zfeuers1/Junior-Design/Project Documents/PowerManagementV1.jpg

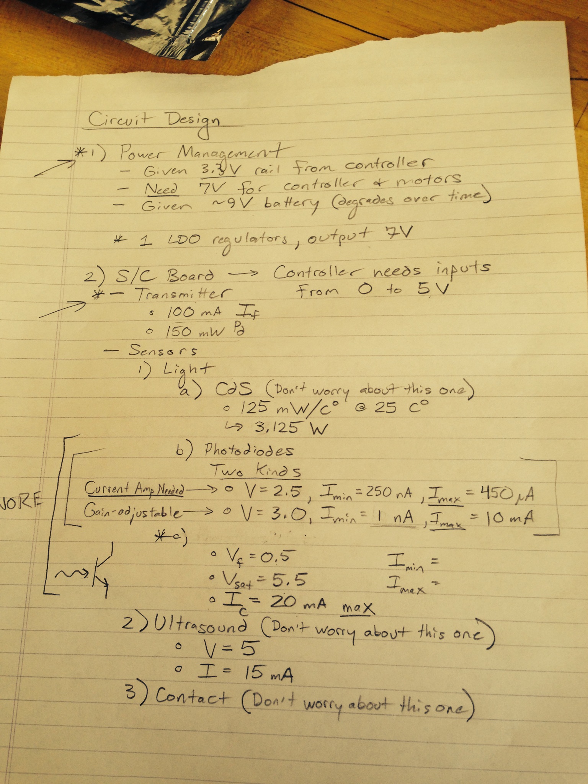
Project Documents/PowerManagementV1.jpg
