zfeuers1/Junior-Design/README.md

Junior-Design-Project
=============

Project for my Junior Design class at Binghamton University (Spring 2014).

Look at "Project Description.pdf" for more details.

Code is all in RobotControl
