zfeuers1/Junior-Design/Project Documents/JDT 18 Design Review/Flowcharts.pdf

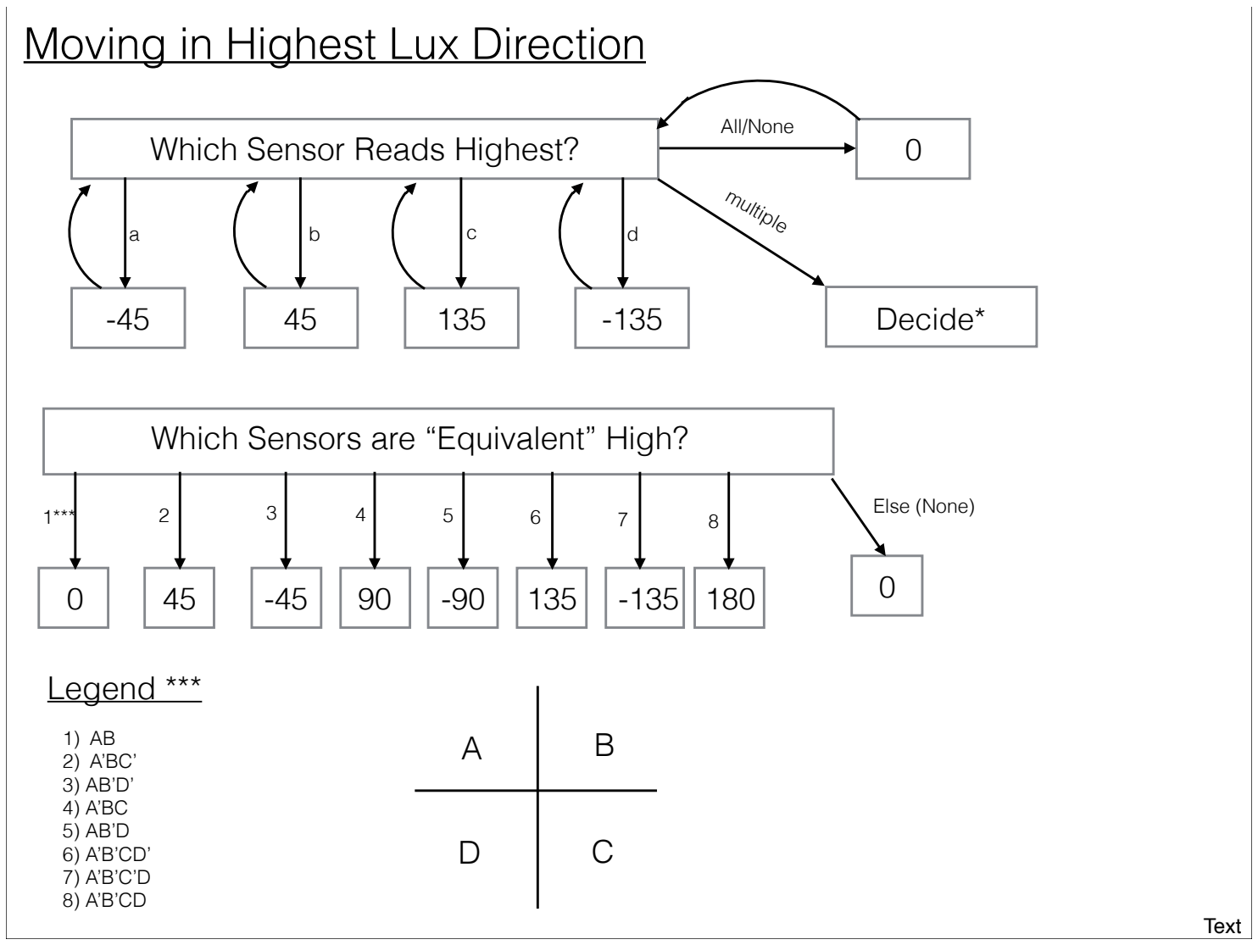
[picture p3: figure]
Moving in Highest Lux Direction; Which Sensor Reads Highest?; Decide*; multiple; All/None; Else (None) 1***; Which Sensors are “Equivalent” High?; Legend ***

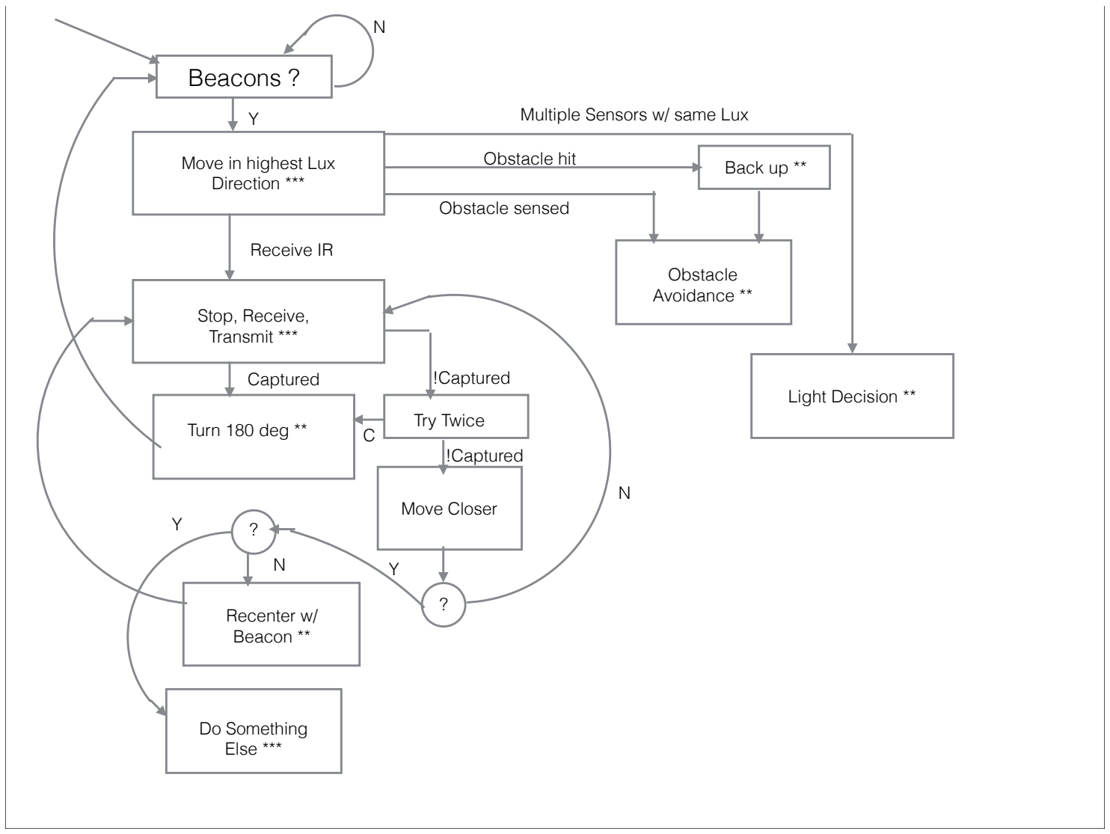
[picture p4: figure]
Beacons ?; Move in highest Lux Direction ***; Multiple Sensors w/ same Lux; Obstacle hit; Obstacle sensed; Back up **; Obstacle Avoidance **; Light Decision **; Stop, Receive, Transmit ***; Receive IR; Captured; !Captured; Try Twice; Turn 180 deg **; Move Closer; Recenter w/ Beacon **; Do Something Else ***

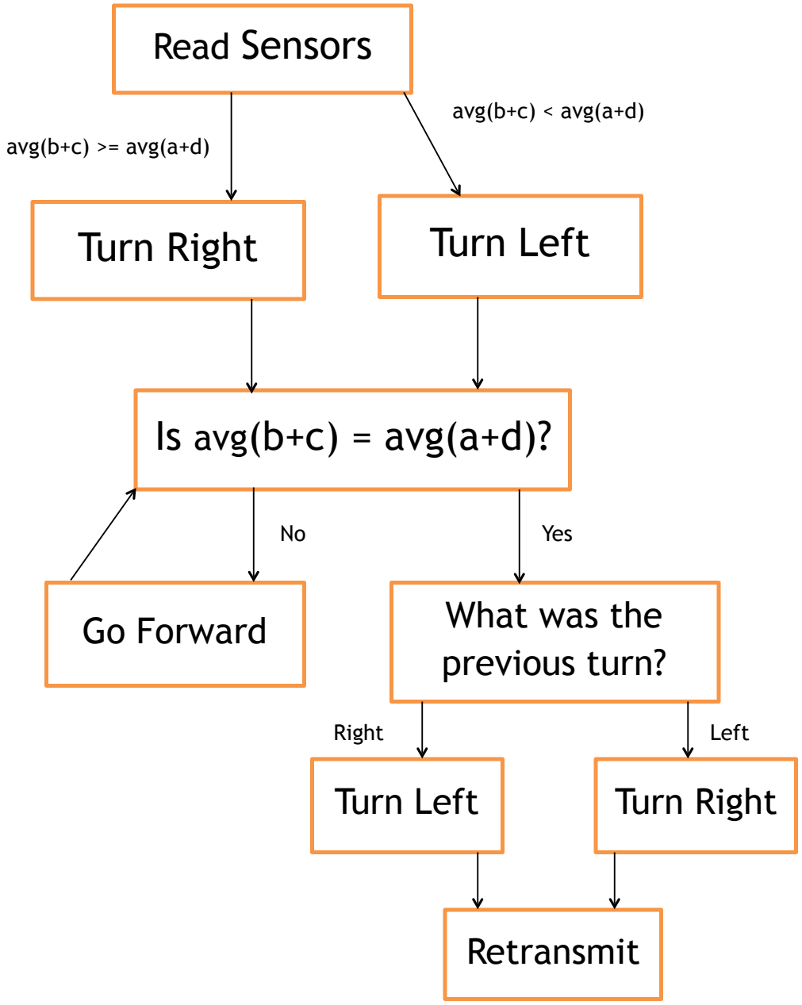
[picture p5: figure]
Read Sensors; Turn Right; Turn Left; Is avg(b+c) = avg(a+d)?; Go Forward; What was the; previous turn?; Retransmit; avg(b+c) >= avg(a+d); avg(b+c) < avg(a+d); Yes; Right; Left
