zfeuers1/Junior-Design/Project Documents/JDT 18 Design Review/BlockDiagram.pdf

# Block Diagram

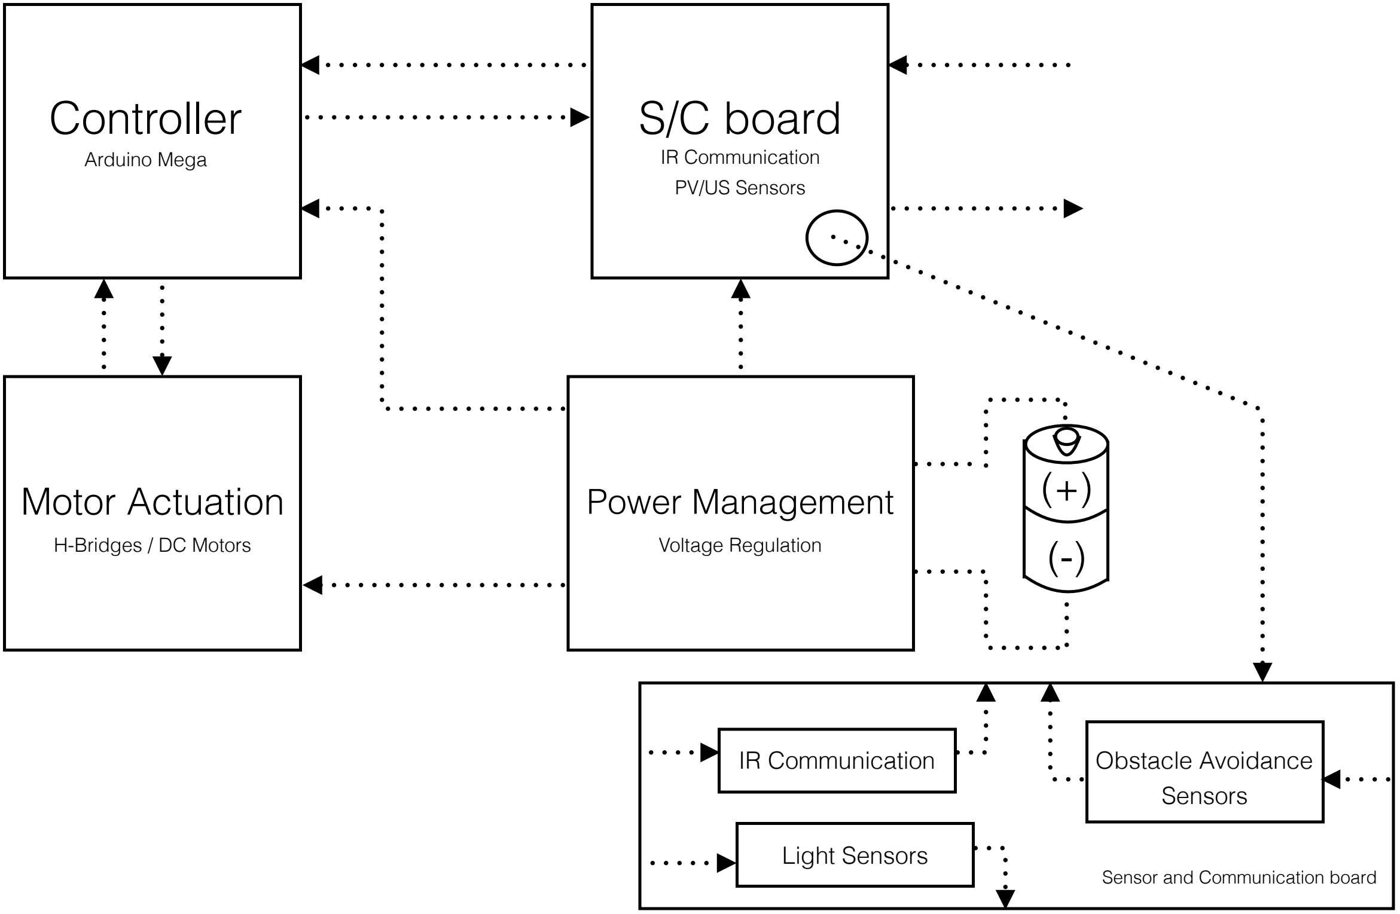
[picture p6: figure]
Controller; S/C board; Motor Actuation; Power Management; Arduino Mega; IR Communication; PV/US Sensors; H-Bridges / DC Motors; Light Sensors; Sensor and Communication board; Obstacle Avoidance Sensors; Voltage Regulation

# Controller

# Arduino Mega Atmel

## Atmega 2560

Analog I/O Pins | Communication Pins

# Digital I/O Pins

# Digital I/O Pins

## Power

## USB

# Motor Actuation

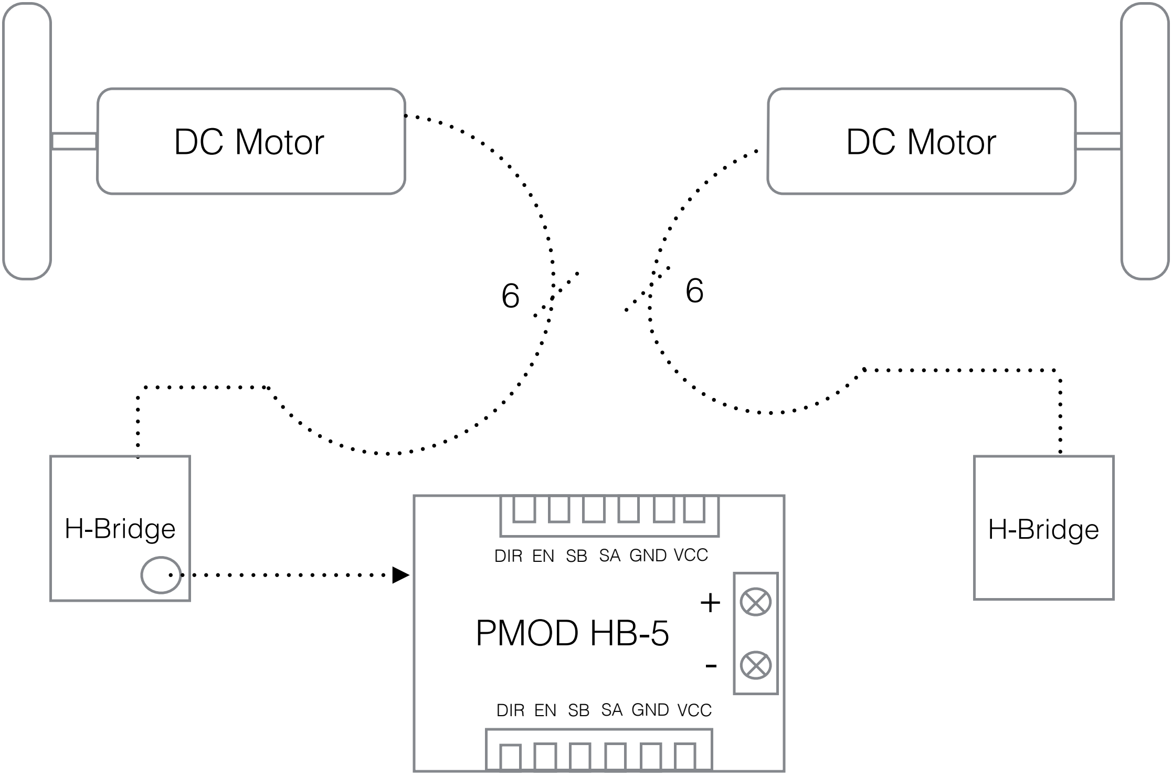
[picture p7: figure]
H-Bridge; DC Motor; DIR EN SB SA GND VCC; PMOD HB-5

# Sensors and Communications

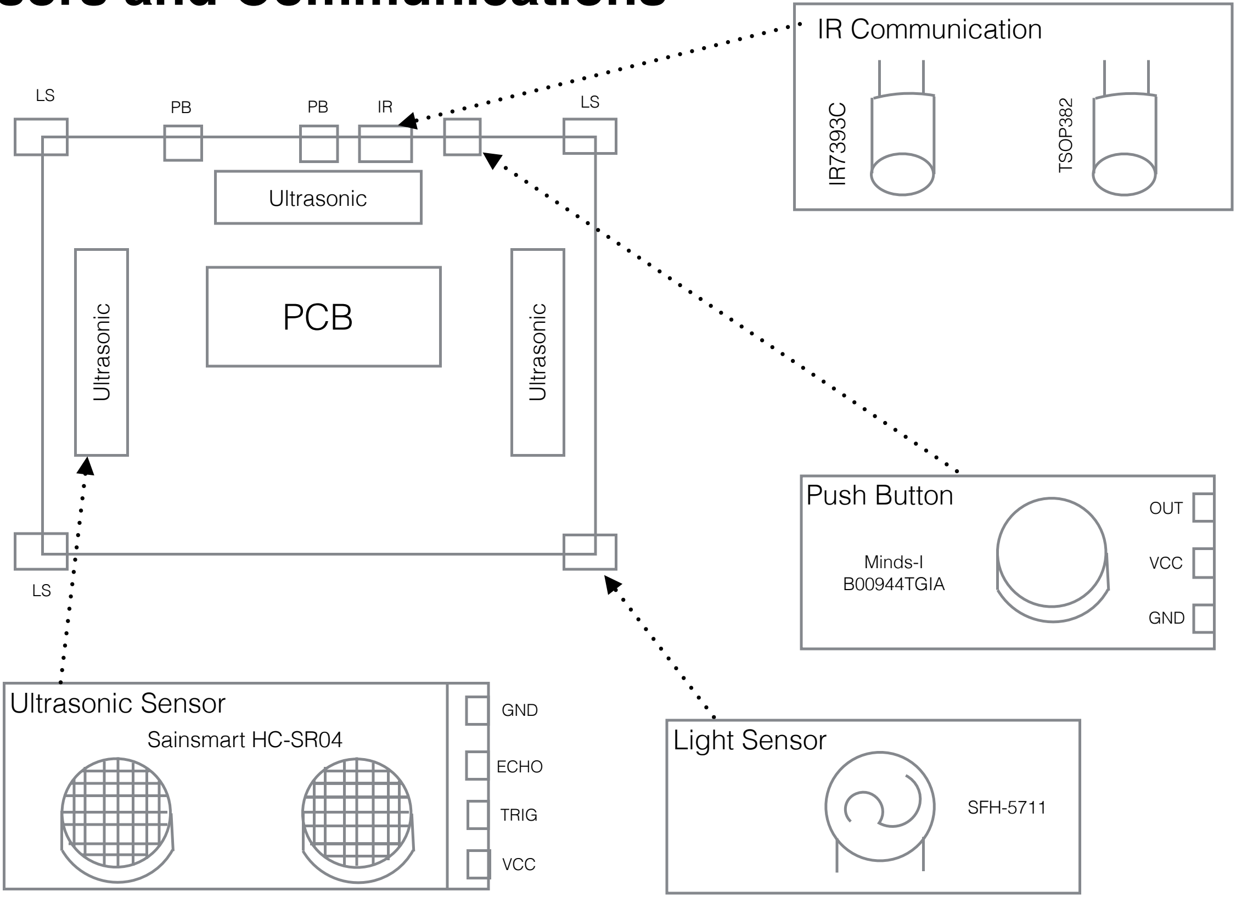
[picture p8: figure]
Ultrasonic; IR Communication; Light Sensor; Push Button; Ultrasonic Sensor; OUT; VCC; GND; Minds-I B00944TGIA; PCB; TSOP382; SFH-5711; Sainsmart HC-SR04; ECHO; TRIG

# Power Management

9v

# GND

# GND 5v

3.3uF

# Batteries

# MIC5239

+

# 5v Rail
