zfeuers1/Junior-Design/Project Documents/JDT 18 Design Review/PSPICE Simulations.pdf

SFH 5711 - Photodiode

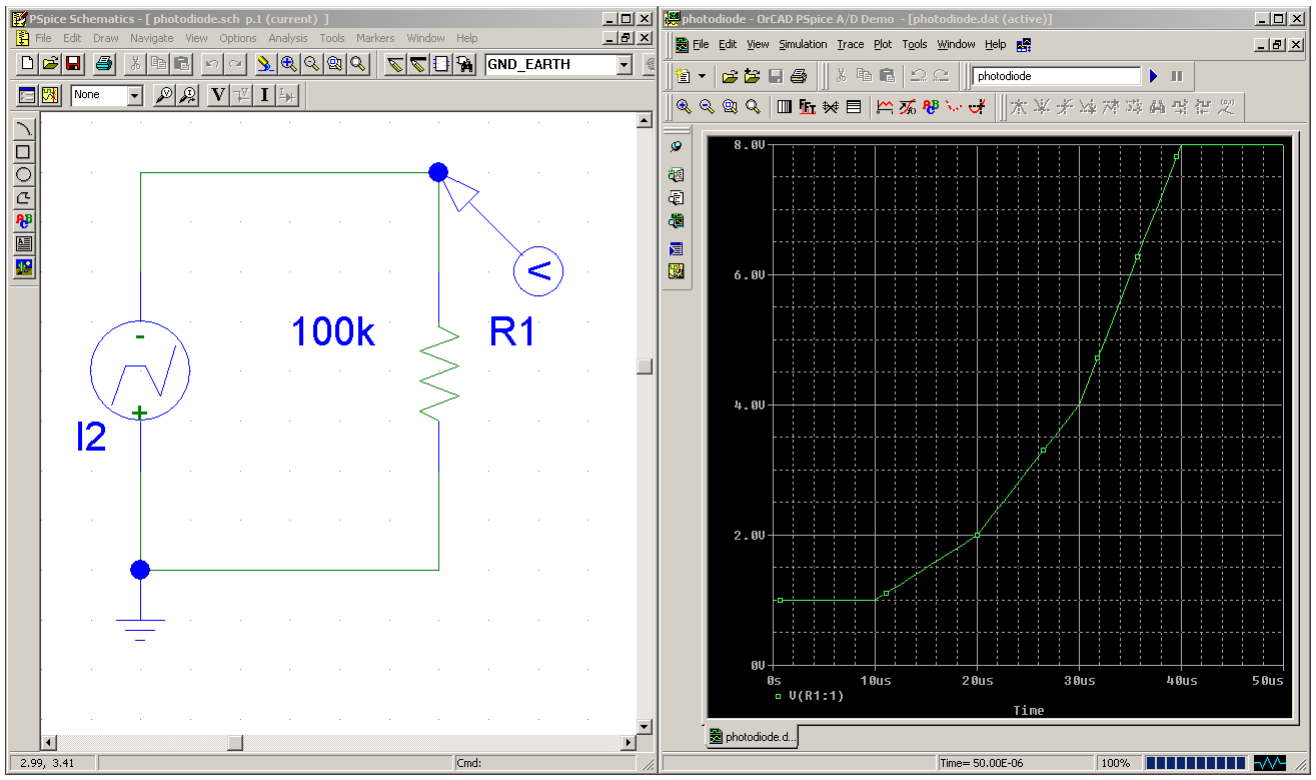
[picture p9: figure]

IR Transmitter Circuit (Clock Signals acting as IR_CC and 38_kHz)

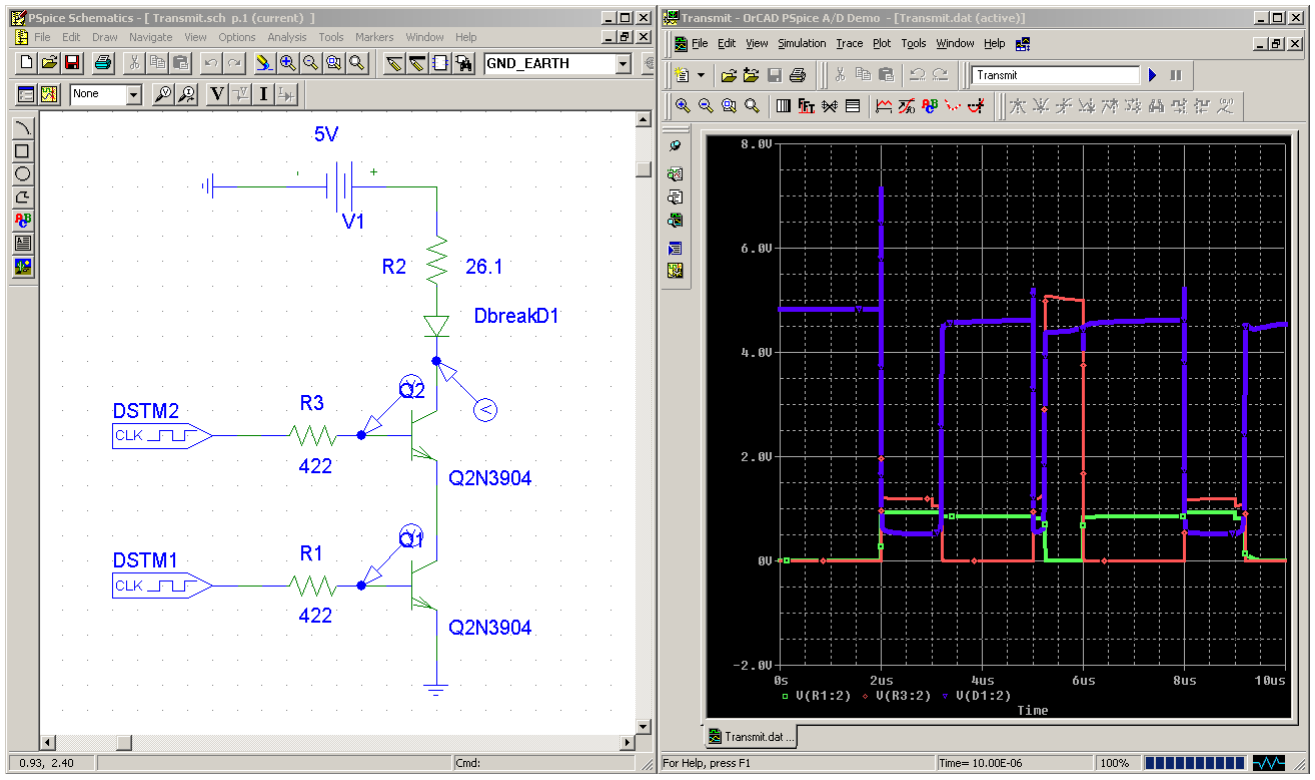
[picture p10: figure]
