zfeuers1/Junior-Design/Project Documents/LSnew.pdf

# Moving in Highest Lux Direction

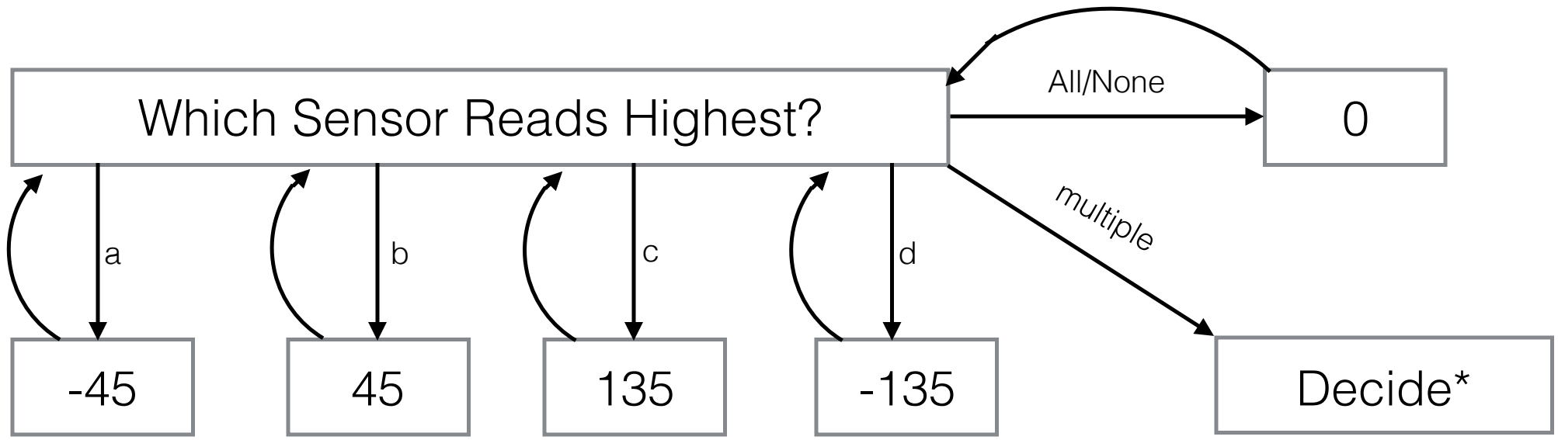
[picture p11: figure]
Which Sensor Reads Highest?; Decide*; multiple; All/None

Else (None) 1*** | 2 | 3 | 4 | 5 | 6 | 7 | 8
0 | 45 | -45 | 90 | -90 | 135 | -135 180 | 0

## Which Sensors are “Equivalent” High?

## Legend ***

1) AB
2) A’BC’
3) AB’D’
4) A’BC
5) AB’D
6) A’B’CD’
7) A’B’C’D
8) A’B’CD
A | B
D | C

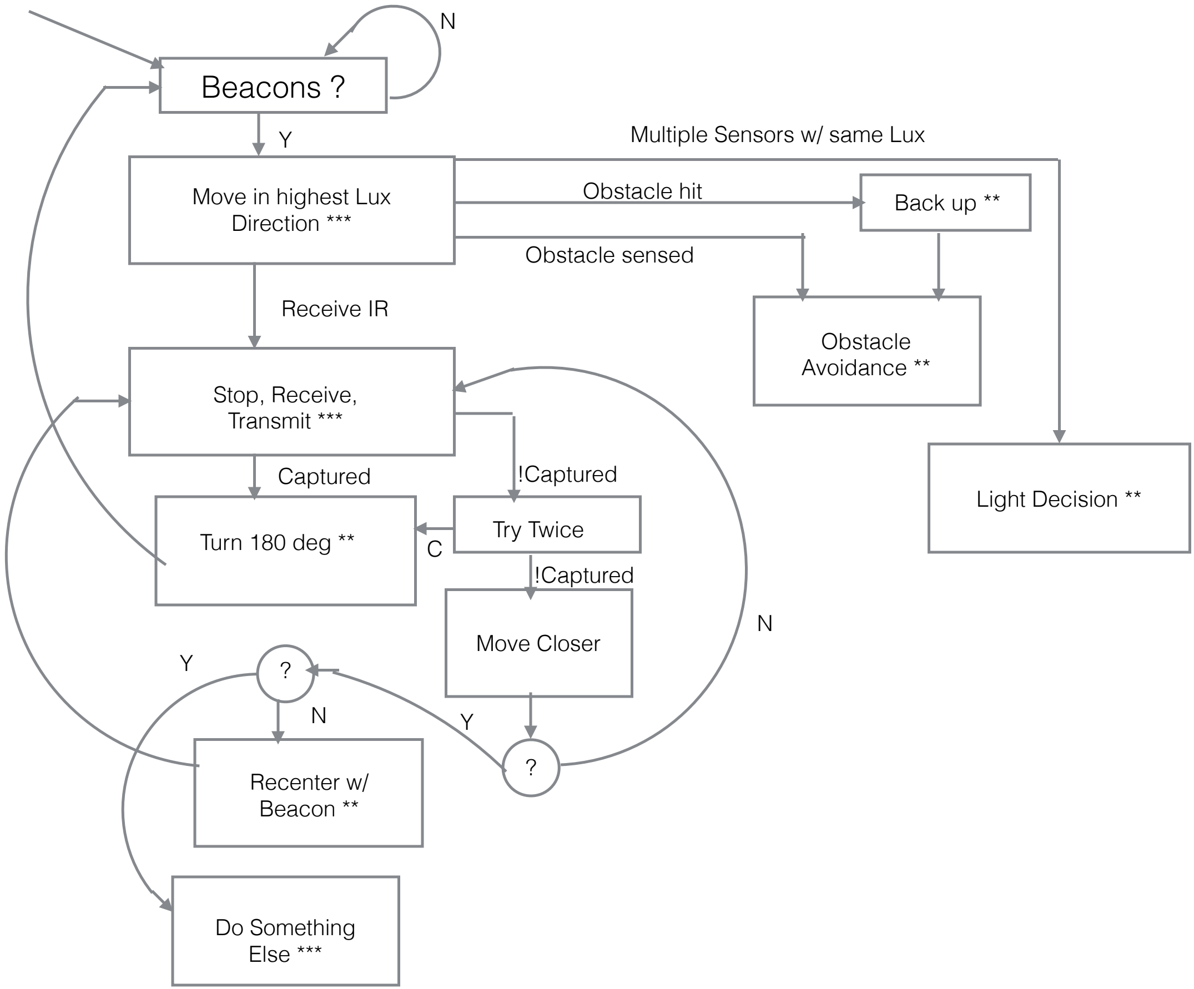
[picture p12: figure]
Beacons ?; Move in highest Lux Direction ***; Multiple Sensors w/ same Lux; Obstacle hit; Obstacle sensed; Back up **; Obstacle Avoidance **; Light Decision **; Stop, Receive, Transmit ***; Receive IR; Captured; !Captured; Try Twice; Turn 180 deg **; Move Closer; Recenter w/ Beacon **; Do Something Else ***
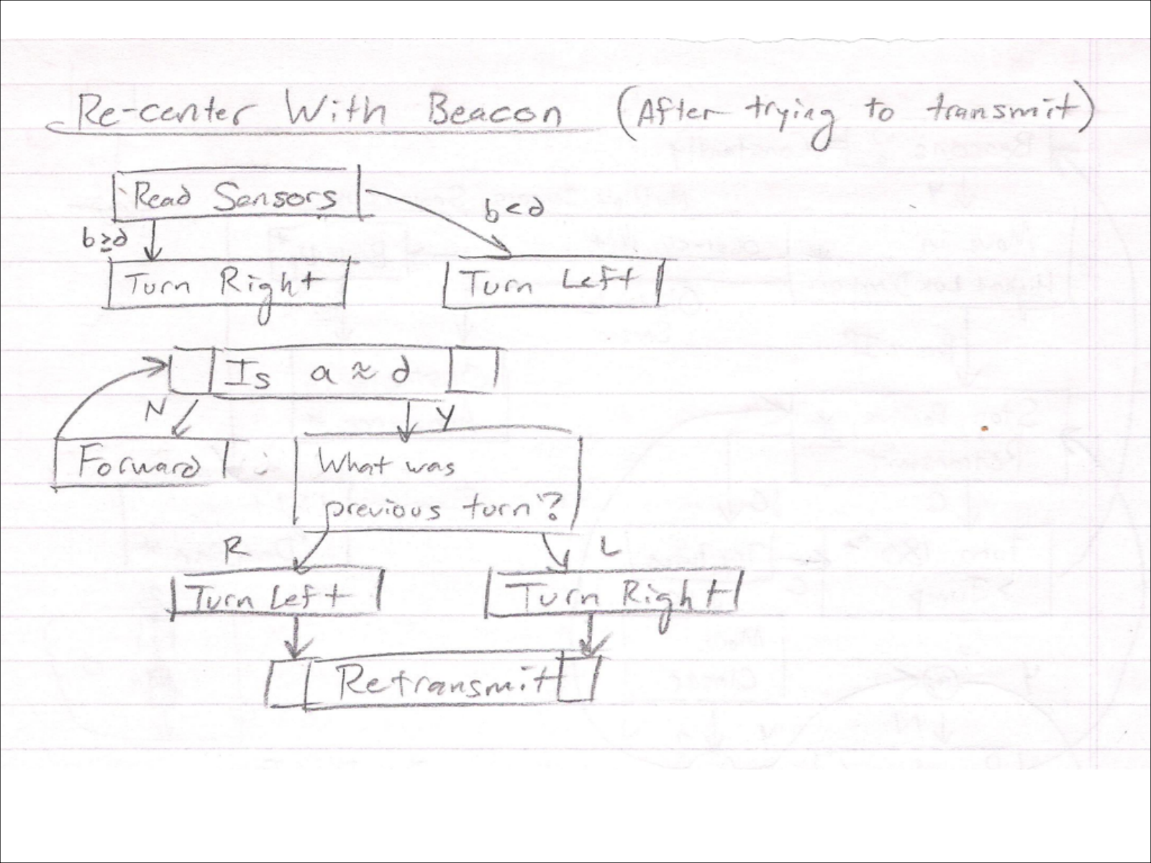
[picture p13: page 3]
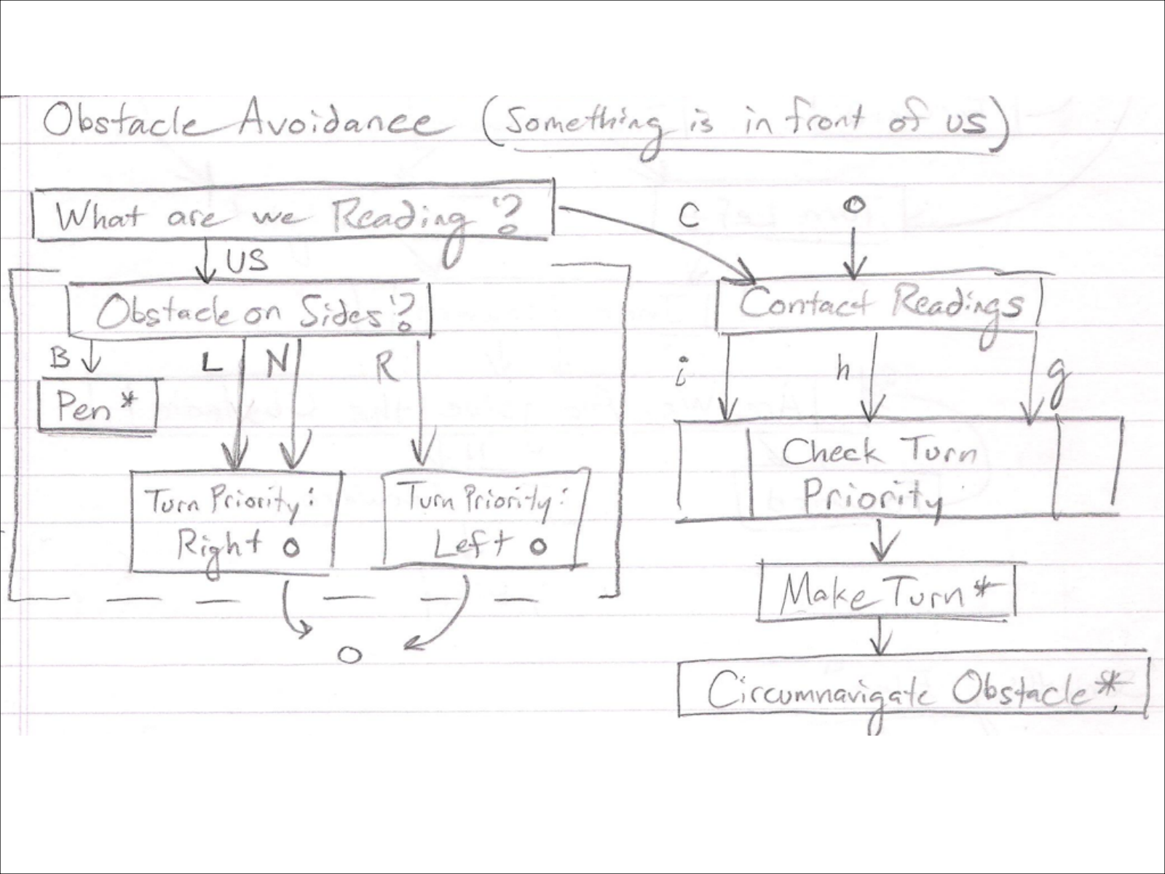
[picture p14: page 4]
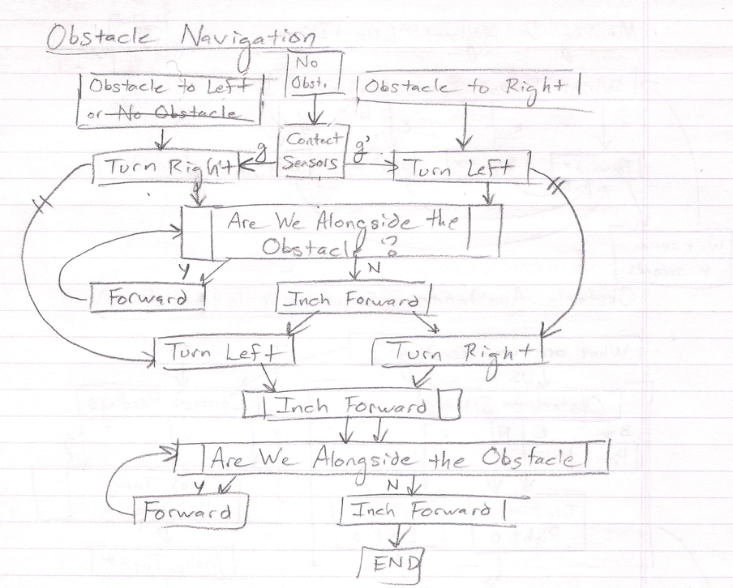
[picture p15: page 5]
