zfeuers1/Junior-Design/Project Documents/BlockDiagram.pdf

# Block Diagram

Controller; S/C board; Motor Actuation; Power Management; Arduino Mega; IR Communication; PV/US Sensors; H-Bridges / DC Motors; Light Sensors; Sensor and Communication board; Obstacle Avoidance Sensors; Voltage Regulation

# Controller

# Arduino Mega Atmel

## Atmega 2560

Analog I/O Pins | Communication Pins

# Digital I/O Pins

# Digital I/O Pins

## Power

## USB

# Motor Actuation

H-Bridge; DC Motor; DIR EN SB SA GND VCC; PMOD HB-5

# Sensors and Communications

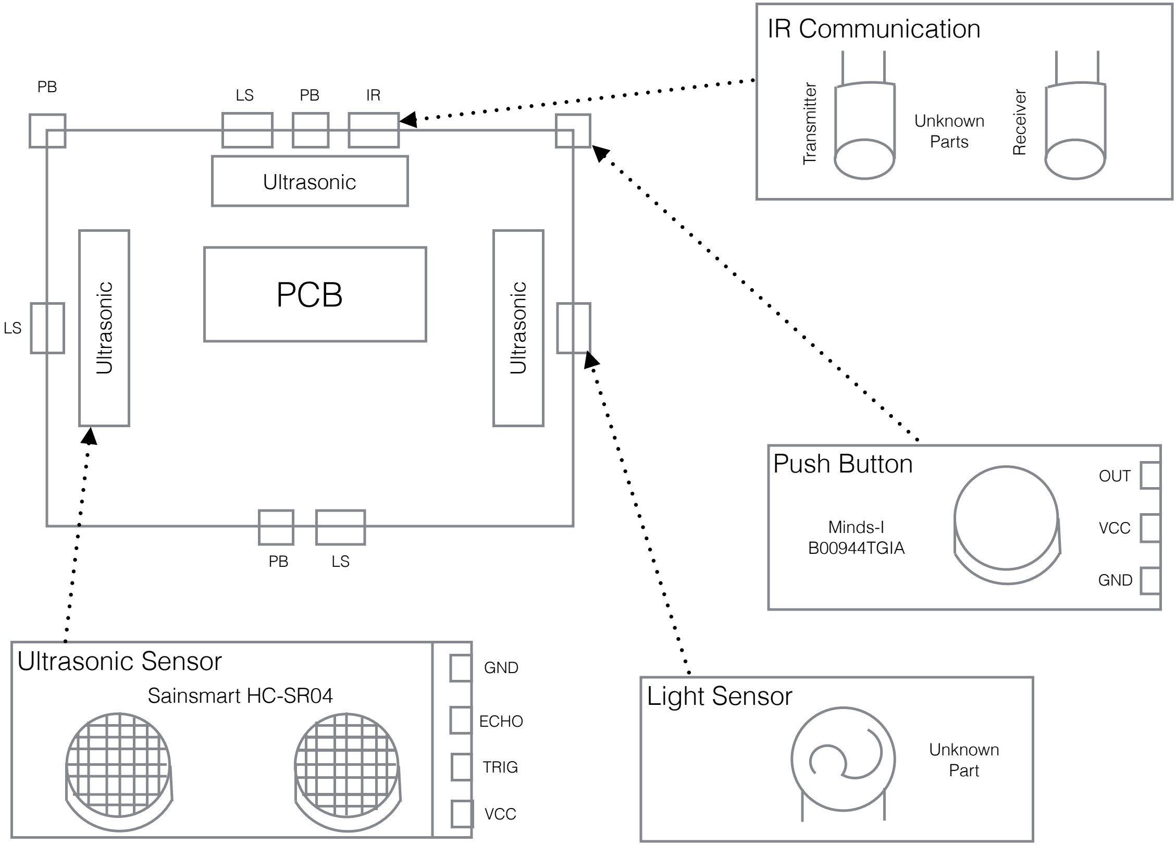
[picture p16: figure]
Ultrasonic; IR Communication; Light Sensor; Push Button; Ultrasonic Sensor; OUT; VCC; GND; Minds-I B00944TGIA; PCB; Transmitter; Receiver; Unknown Part; Unknown Parts; Sainsmart HC-SR04; ECHO; TRIG

# Power Management
