zfeuers1/Junior-Design/Project Documents/Schematic.pdf

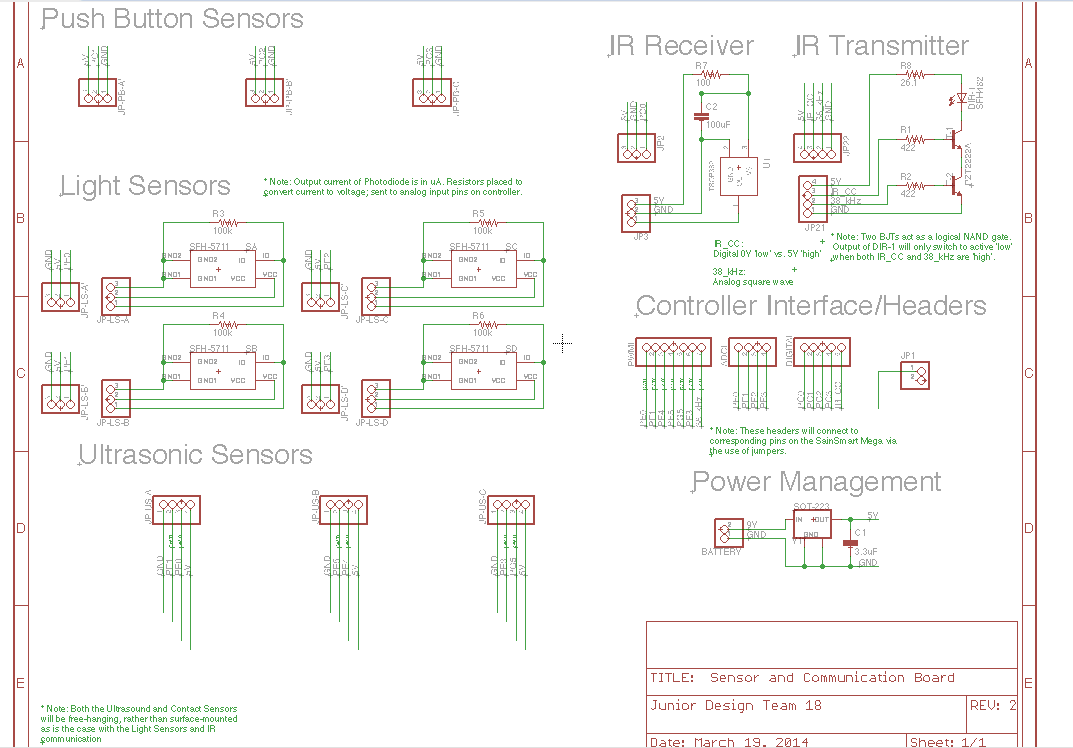
[picture p17: figure]
