zfeuers1/Junior-Design/Project Documents/JDT 18 Design Review/IR Transmitter Justifications.pdf

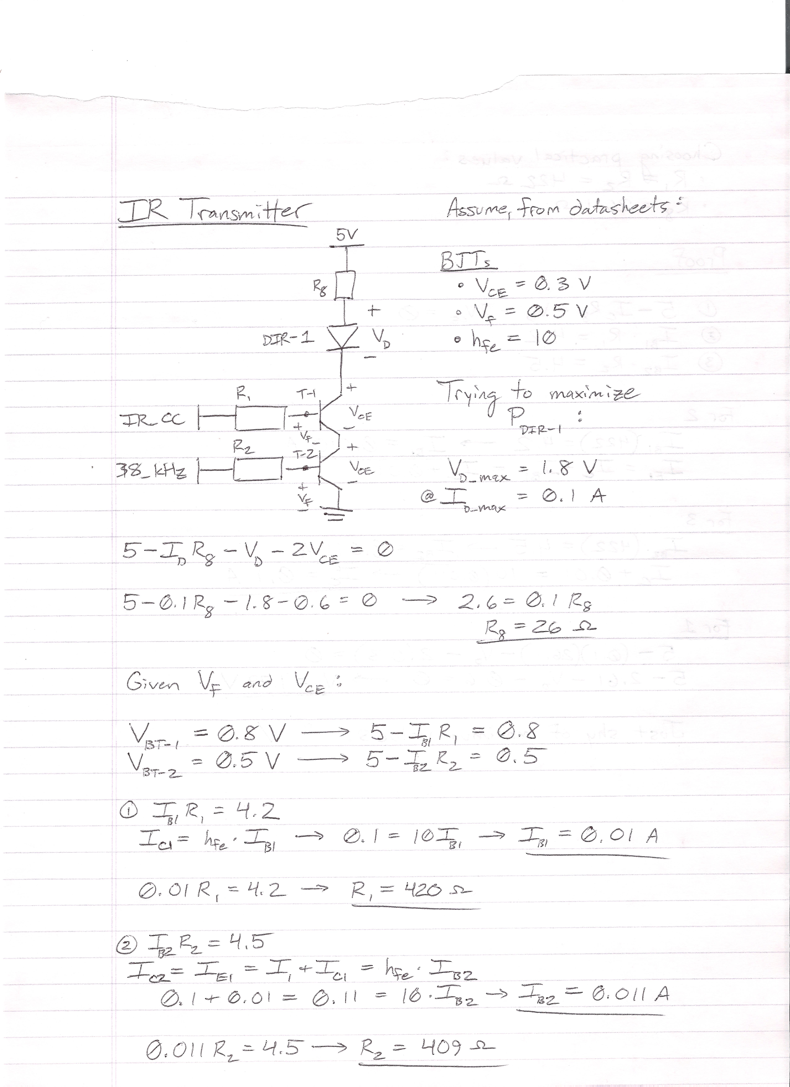
[picture p18: page 1]
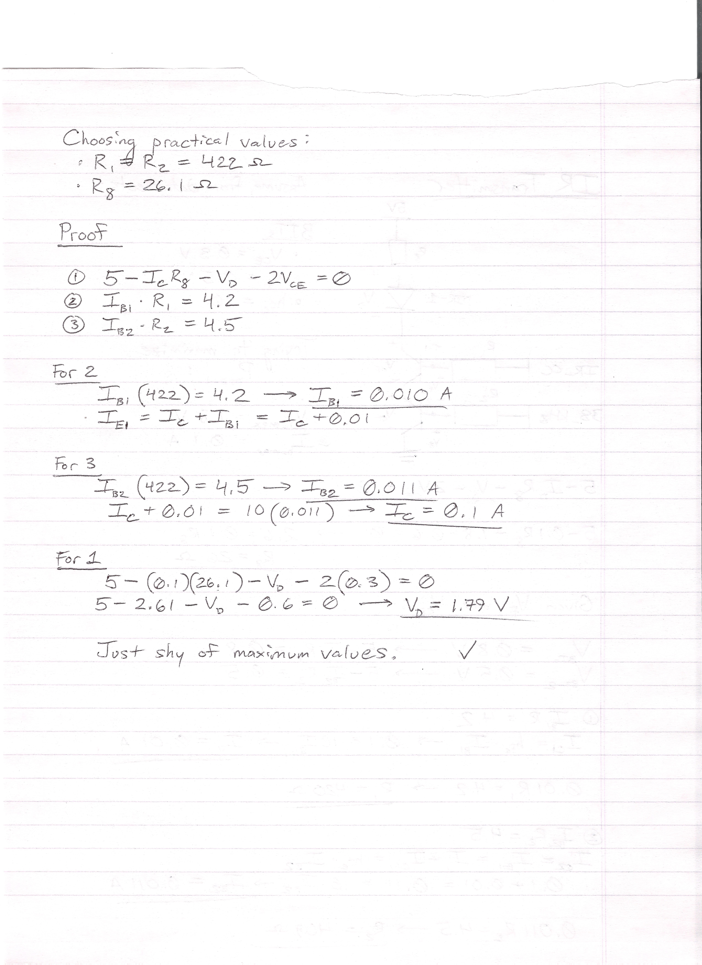
[picture p19: page 2]
