zfeuers1/Junior-Design/Project Documents/JDT 18 Design Review/Schematic:PCB/PCB/IR Transmitter and Reciever.pdf

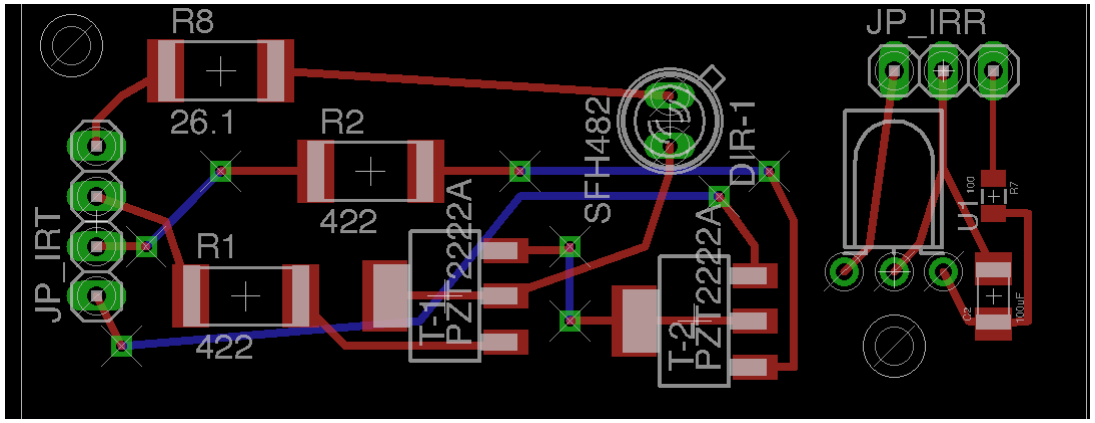
[picture p20: figure]
