zfeuers1/Junior-Design/Project Documents/JDT 18 Design Review/Schematic:PCB/PCB/Light Sensor.pdf

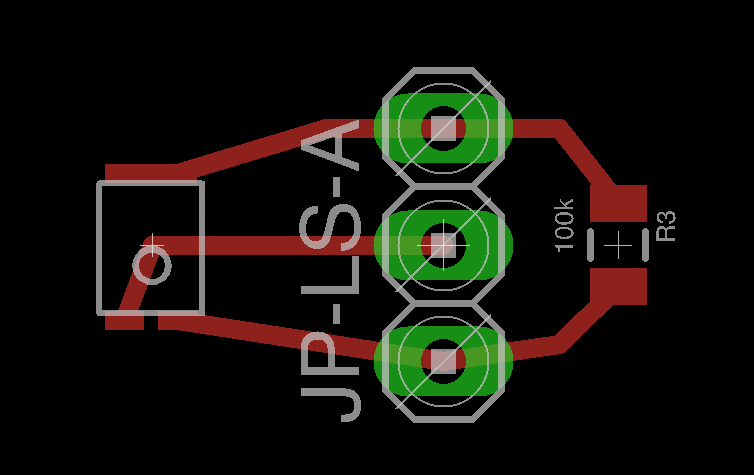
[picture p21: figure]
