zfeuers1/Junior-Design/Project Documents/JDT 18 Design Review/Schematic:PCB/PCB/PCB.pdf

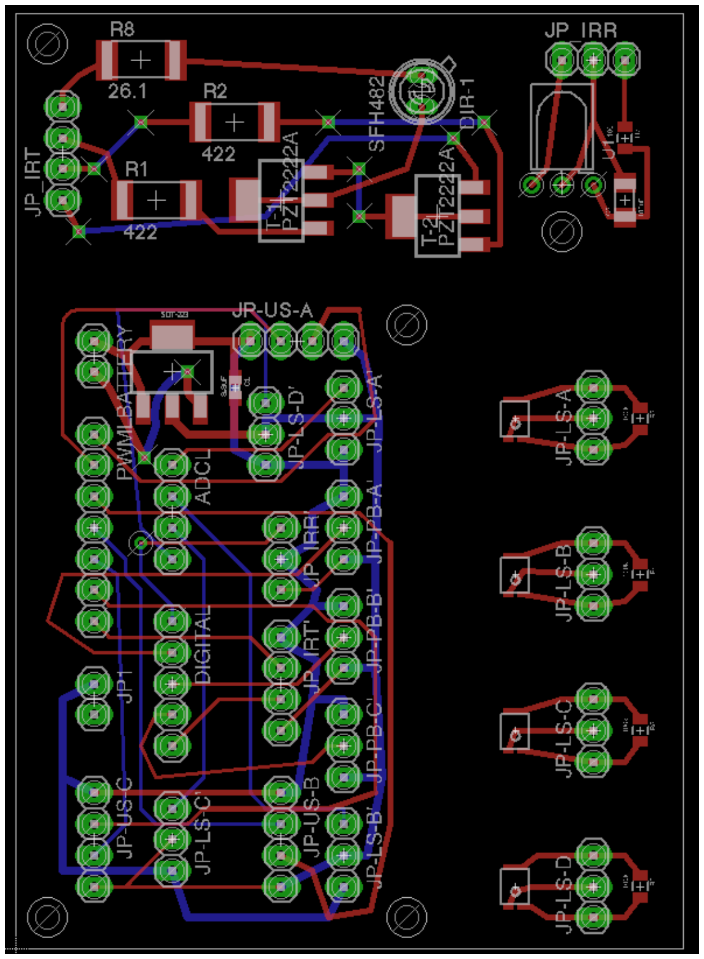
[picture p22: page 1]
