zfeuers1/Junior-Design/Project Documents/IR Reciever and Transmitter.pdf

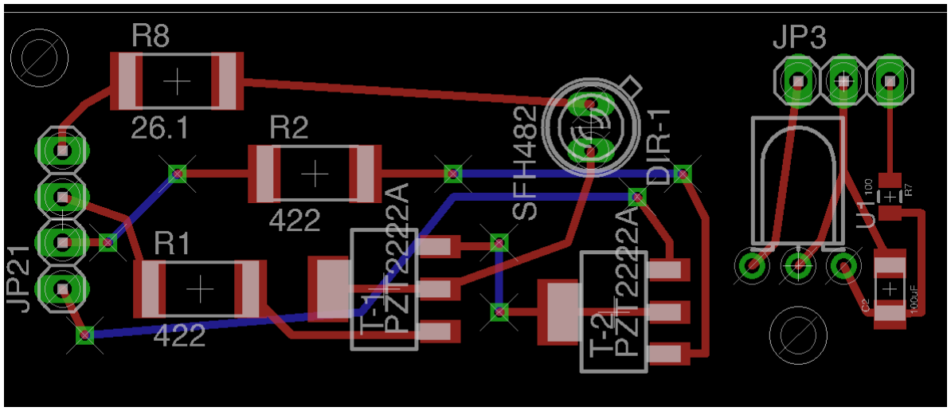
[picture p23: figure]
