zfeuers1/Junior-Design/Project Documents/PCB.pdf

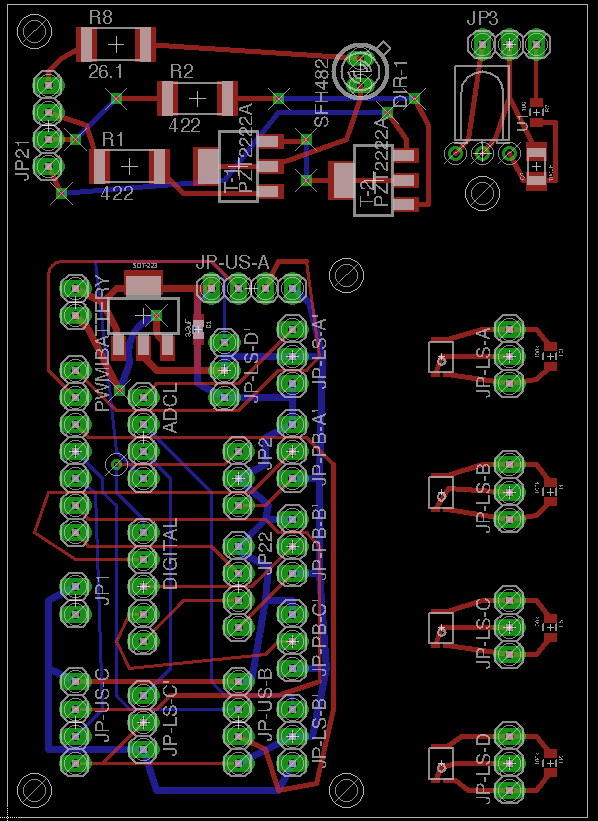
[picture p24: page 1]
