zfeuers1/Junior-Design/Project Documents/BlockDiagram.key/Data/st0-710.jpg

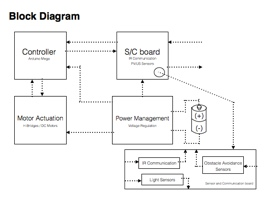
Project Documents/BlockDiagram.key/Data/st0-710.jpg
