zfeuers1/Junior-Design/Project Documents/BlockDiagram.key/Data/st1-819.jpg

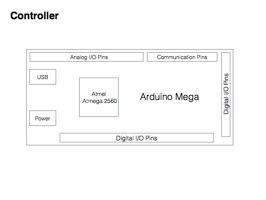
Project Documents/BlockDiagram.key/Data/st1-819.jpg
