zfeuers1/Junior-Design/Project Documents/BlockDiagram.key/Data/st2-1750.jpg

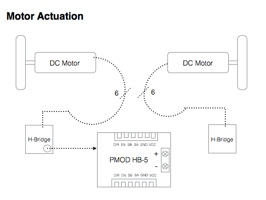
Project Documents/BlockDiagram.key/Data/st2-1750.jpg
