zfeuers1/Junior-Design/Project Documents/BlockDiagram.key/Data/st3-1954.jpg

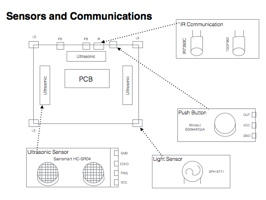
Project Documents/BlockDiagram.key/Data/st3-1954.jpg
