zfeuers1/Junior-Design/Project Documents/BlockDiagram.key/Data/st4-1948.jpg

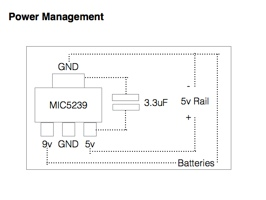
Project Documents/BlockDiagram.key/Data/st4-1948.jpg
