zfeuers1/Junior-Design/Project Documents/Flowcharts.key/Data/pasted-image-small-515.png

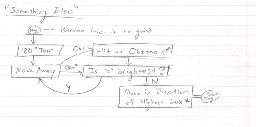
Project Documents/Flowcharts.key/Data/pasted-image-small-515.png
