zfeuers1/Junior-Design/Project Documents/Flowcharts.key/Data/pasted-image-small-532.png

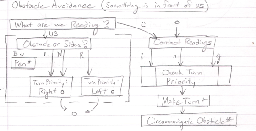
Project Documents/Flowcharts.key/Data/pasted-image-small-532.png
