zfeuers1/Junior-Design/Project Documents/Flowcharts.key/Data/pasted-image-small-543.png

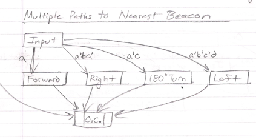
Project Documents/Flowcharts.key/Data/pasted-image-small-543.png
