zfeuers1/Junior-Design/Project Documents/Flowcharts.key/Data/pasted-image-small-549.png

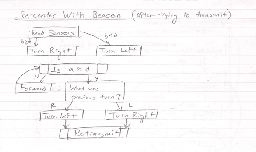
Project Documents/Flowcharts.key/Data/pasted-image-small-549.png
