zfeuers1/Junior-Design/Project Documents/Flowcharts.key/Data/st1-571.jpg

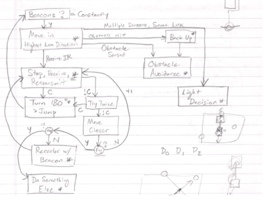
Project Documents/Flowcharts.key/Data/st1-571.jpg
