zfeuers1/Junior-Design/Project Documents/Flowcharts.key/Data/st2-520.jpg

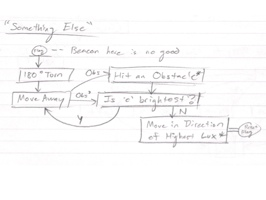
Project Documents/Flowcharts.key/Data/st2-520.jpg
