zfeuers1/Junior-Design/Project Documents/Flowcharts.key/Data/st3-529.jpg

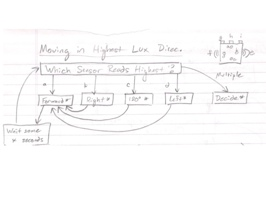
Project Documents/Flowcharts.key/Data/st3-529.jpg
