zfeuers1/Junior-Design/Project Documents/Flowcharts.key/Data/st5-546.jpg

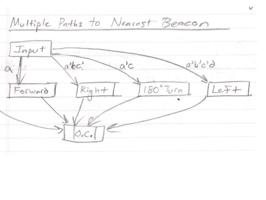
Project Documents/Flowcharts.key/Data/st5-546.jpg
