zfeuers1/Junior-Design/Project Documents/Flowcharts.key/Data/st5-576.jpg

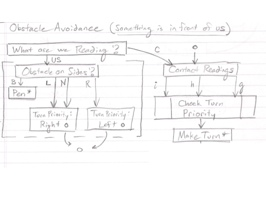
Project Documents/Flowcharts.key/Data/st5-576.jpg
