zfeuers1/Junior-Design/Project Documents/Flowcharts.key/Data/st6-560.jpg

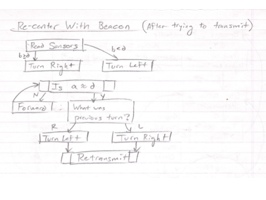
Project Documents/Flowcharts.key/Data/st6-560.jpg
