zfeuers1/Junior-Design/Schematics/Final Schematics/Screen Shot 2014-04-04 at 2.54.39 PM.png

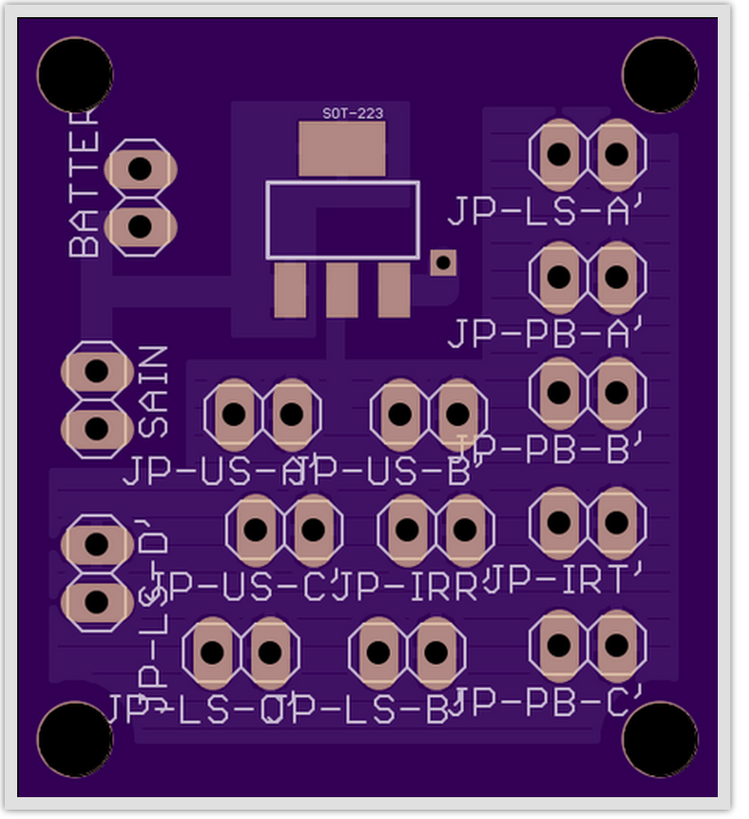
Schematics/Final Schematics/Screen Shot 2014-04-04 at 2.54.39 PM.png
