zfeuers1/Junior-Design/Schematics/Final Schematics/Screen Shot 2014-04-04 at 3.04.48 PM.png

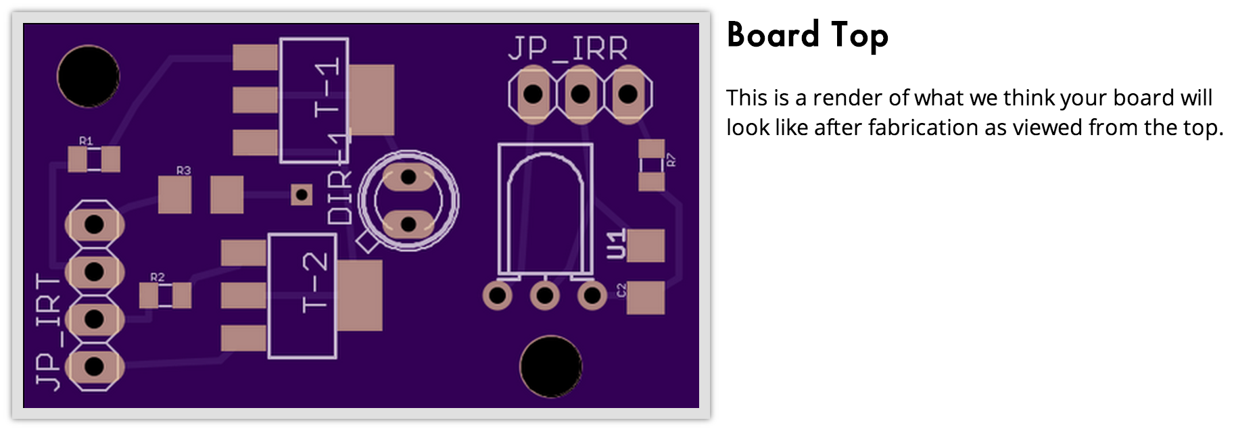
Schematics/Final Schematics/Screen Shot 2014-04-04 at 3.04.48 PM.png
