zfeuers1/Junior-Design/Independent Assignement/Independent Assignment.asc

C2: cap; .1µ
C3: cap; 1nF
D1: LED; NSPW500BS
Q1: npn; 2N2222
R1: res; 10
R2: res; 4.7k
R3: res; 100k
R4: res; 17k
U1: NE555
V1: voltage; 5
Named nets: 0
.tran 0 .125ms
