zfeuers1/Junior-Design/Independent Assignement/Independent_Assignment.brd

## EAGLE design Independent Assignement/Independent_Assignment.brd (2014-04-17)

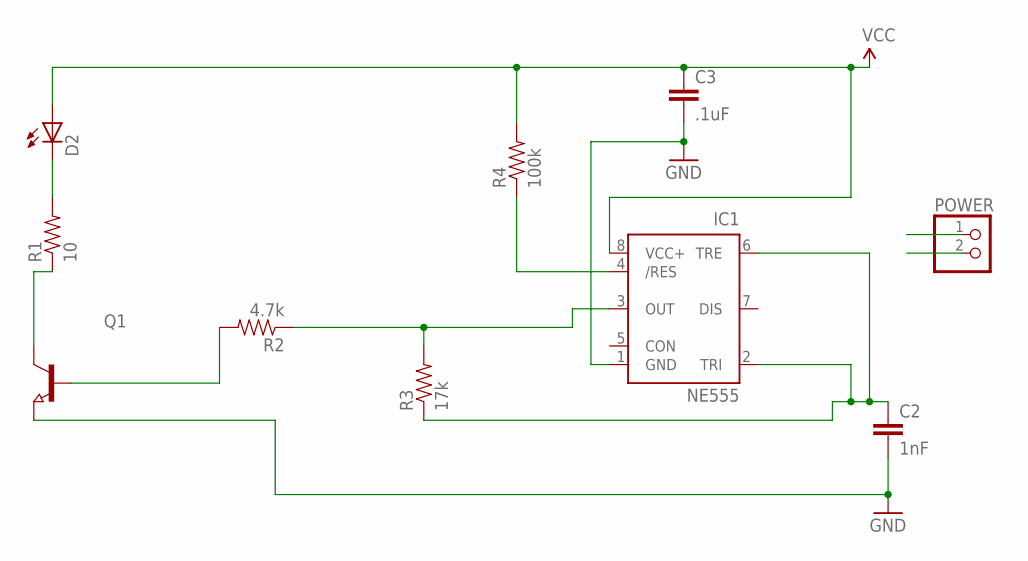
[picture p44: schematic Independent_Assignment.sch]

Parts:
C2: 1nF; 0603-CAP
C3: .1uF; 0603-CAP
D2: SFH482
IC1: NE555; DIL-08
POWER: PINHD-1X2; 1X02
Q1: NPN-TRANSISTOR_SOT23W; SOT23W
R1: 10; 0603-RES
R2: 4.7k; 0603-RES
R3: 17k; 0603-RES
R4: 100k; 0603-RES

Connections:
GND: C2.2, C3.2, IC1.1 (GND), POWER.2, Q1.3 (E)
unnamed: C2.1, IC1.2 (TRI), IC1.6 (TRE), R3.1
unnamed: D2.K (C), R1.2
unnamed: Q1.2 (C), R1.1
unnamed: Q1.1 (B), R2.2
unnamed: IC1.3 (OUT), R2.1, R3.2
unnamed: IC1.4 (/RES), R4.1
VCC: C3.1, D2.A, IC1.8 (VCC+), POWER.1, R4.2

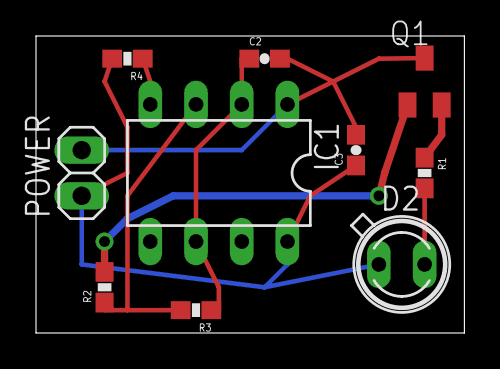
[picture p45: board Independent_Assignment.brd from above]

Board: 2 copper layers, 23.8 x 16.5 mm, 10 parts (0 on the bottom side), 8 nets.
