zfeuers1/Junior-Design/Schematics/Old Schematics/Schematics V2/Final Schematic.brd

## EAGLE design Schematics/Old Schematics/Schematics V2/Final Schematic.brd (2014-04-17, an earlier design)

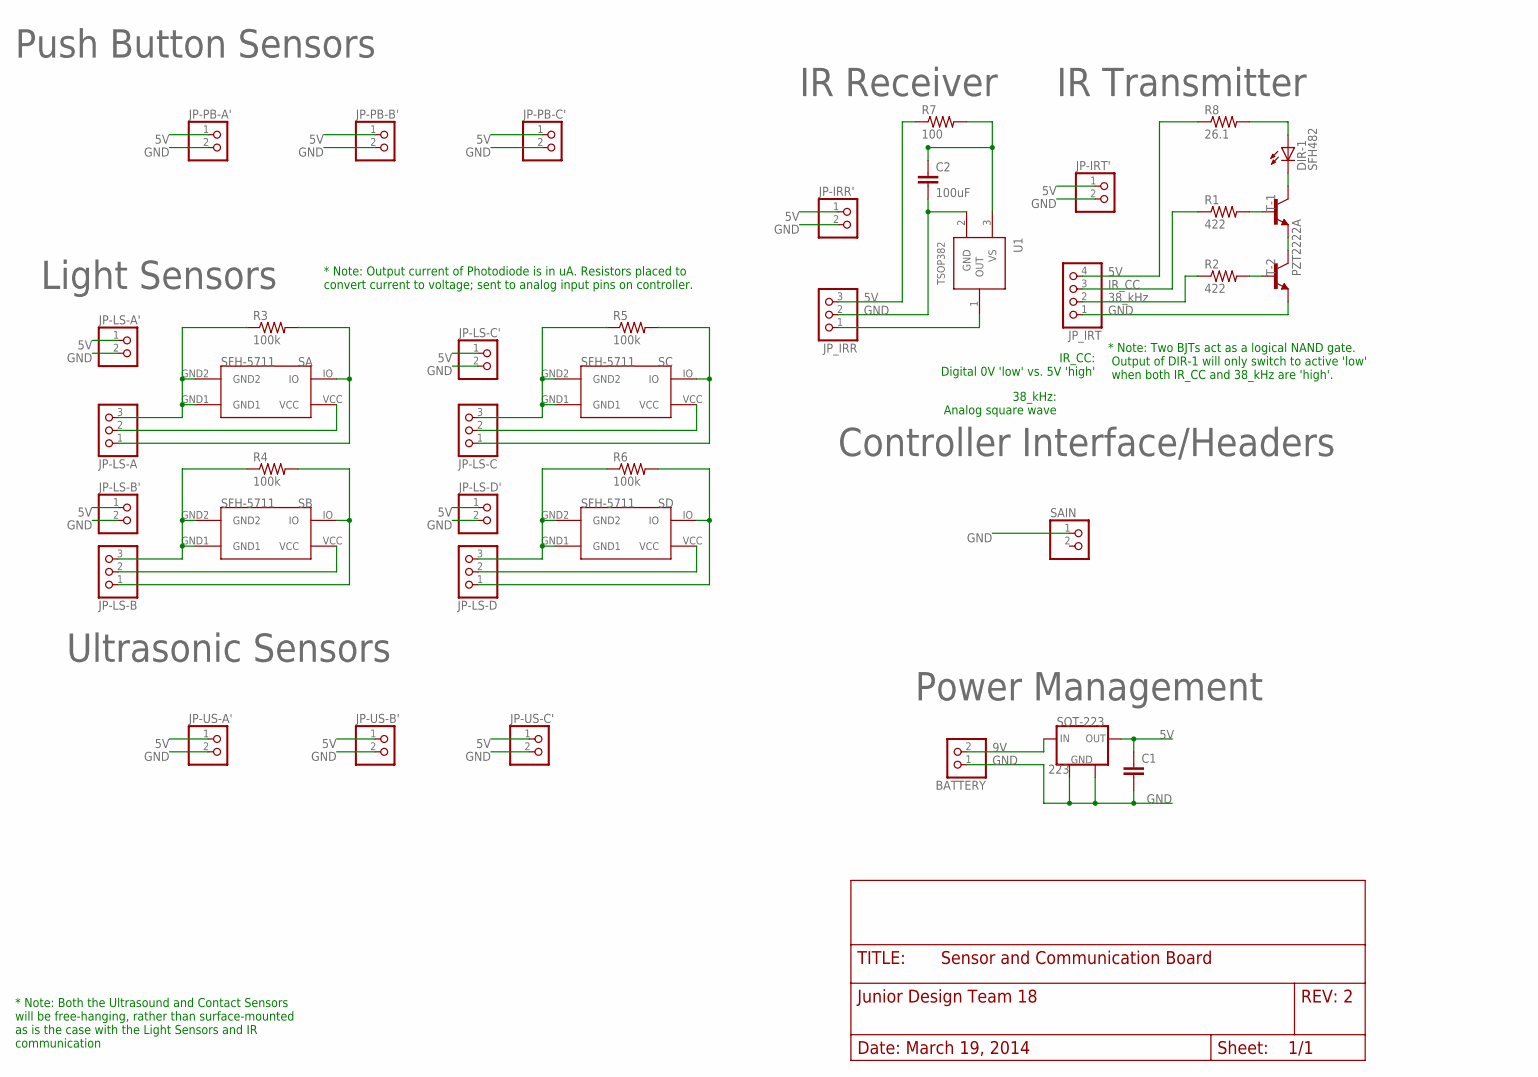
[picture p46: schematic Final Schematic.sch]

Parts:
BATTERY: PINHD-1X2; 1X02
C1: CAP0603-CAP; 0603-CAP
C2: 100uF; 1206
DIR-1: SFH482
JP-IRR': PINHD-1X2; 1X02
JP-IRT': PINHD-1X2; 1X02
JP-LS-A: PINHD-1X3; 1X03
JP-LS-A': PINHD-1X2; 1X02
JP-LS-B: PINHD-1X3; 1X03
JP-LS-B': PINHD-1X2; 1X02
JP-LS-C: PINHD-1X3; 1X03
JP-LS-C': PINHD-1X2; 1X02
JP-LS-D: PINHD-1X3; 1X03
JP-LS-D': PINHD-1X2; 1X02
JP-PB-A': PINHD-1X2; 1X02
JP-PB-B': PINHD-1X2; 1X02
JP-PB-C': PINHD-1X2; 1X02
JP-US-A': PINHD-1X2; 1X02
JP-US-B': PINHD-1X2; 1X02
JP-US-C': PINHD-1X2; 1X02
JP_IRR: PINHD-1X3; 1X03
JP_IRT: PINHD-1X4; 1X04
R1, R2: 422; R2512
R3, R4, R5, R6: 100k; 0805
R7: 100; 0805
R8: 26.1; R2512
SAIN: PINHD-1X2; 1X02
SFH-5711-A, SFH-5711-B, SFH-5711-C, SFH-5711-D: 5711; DIODE
SOT-223: 223; SOT223
T-1, T-2: PZT2222A; SOT223
U1: TSOP382

Connections:
5V: C1.1, JP-IRR'.1, JP-IRT'.1, JP-LS-A'.1, JP-LS-B'.1, JP-LS-C'.1, JP-LS-D'.1, JP-PB-A'.1, JP-PB-B'.1, JP-PB-C'.1, JP-US-A'.1, JP-US-B'.1, JP-US-C'.1, SOT-223.GND1 (OUT)
9V-BAT: BATTERY.2, SOT-223.OUT (IN)
GND: BATTERY.1, C1.2, JP-IRR'.2, JP-IRT'.2, JP-LS-A'.2, JP-LS-B'.2, JP-LS-C'.2, JP-LS-D'.2, JP-PB-A'.2, JP-PB-B'.2, JP-PB-C'.2, JP-US-A'.2, JP-US-B'.2, JP-US-C'.2, SAIN.1, SOT-223.GND2 (GND1), SOT-223.IN (GND2)
GND-IR-R: C2.2, JP_IRR.2, U1.2 (GND)
GND-IR-T: JP_IRT.1, T-2.3 (E)
GND-LS-A: JP-LS-A.3, R3.1, SFH-5711-A.GND1, SFH-5711-A.GND2
GND-LS-B: JP-LS-B.3, R4.1, SFH-5711-B.GND1, SFH-5711-B.GND2
GND-LS-C: JP-LS-C.3, R5.1, SFH-5711-C.GND1, SFH-5711-C.GND2
GND-LS-D: JP-LS-D.3, R6.1, SFH-5711-D.GND1, SFH-5711-D.GND2
IO-LS-A: JP-LS-A.1, R3.2, SFH-5711-A.IO
IO-LS-B: JP-LS-B.1, R4.2, SFH-5711-B.IO
IO-LS-C: JP-LS-C.1, R5.2, SFH-5711-C.IO
IO-LS-D: JP-LS-D.1, R6.2, SFH-5711-D.IO
unnamed: DIR-1.A, R8.2
unnamed: DIR-1.K (C), T-1.2 (C), T-1.4 (C)
unnamed: R2.2, T-2.1 (B)
unnamed: R1.2, T-1.1 (B)
unnamed: T-1.3 (E), T-2.2 (C), T-2.4 (C)
VCC-IR-R: JP_IRR.3, R7.1
VCC-IR-T: JP_IRT.4, R8.1
VCC-LS-A: JP-LS-A.2, SFH-5711-A.VCC
VCC-LS-B: JP-LS-B.2, SFH-5711-B.VCC
VCC-LS-C: JP-LS-C.2, SFH-5711-C.VCC
VCC-LS-D: JP-LS-D.2, SFH-5711-D.VCC
VIN-IR-1: JP_IRT.3, R1.1
VIN-IR-2: JP_IRT.2, R2.1
VOUT-IR-R: JP_IRR.1, U1.1 (OUT)
VS-IR-R: C2.1, R7.2, U1.3 (VS)

Notes on the sheet:
IR Receiver
IR Transmitter
Light Sensors
Controller Interface/Headers
Ultrasonic Sensors
Push Button Sensors
* Note: Both the Ultrasound and Contact Sensors will be free-hanging, rather than surface-mounted as is the case with the Light Sensors and IR communication
SFH-5711
Power Management
GND
IR_CC
38_kHz
* Note: Two BJTs act as a logical NAND gate. Output of DIR-1 will only switch to active 'low' when both IR_CC and 38_kHz are 'high'.
* Note: Output current of Photodiode is in uA. Resistors placed to convert current to voltage; sent to analog input pins on controller.
38_kHz: Analog square wave
IR_CC: Digital 0V 'low' vs. 5V 'high'

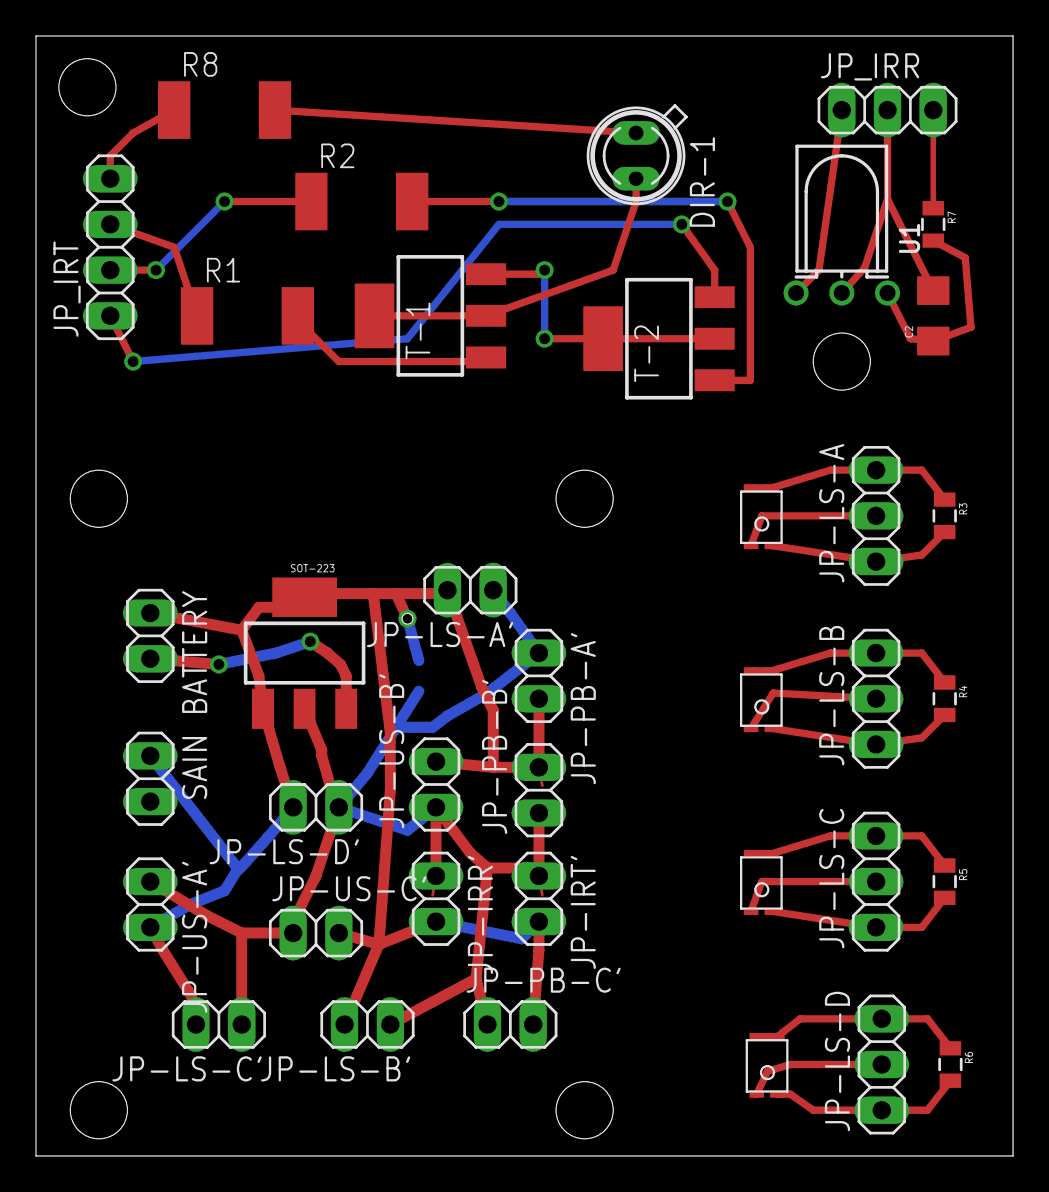
[picture p47: board Final Schematic.brd from above]

Board: 2 copper layers, 54.3 x 62.2 mm, 39 parts (1 on the bottom side), 28 nets.
