zfeuers1/Junior-Design/Schematics/Final Schematics/Power/Power_Schematic.brd

## EAGLE design Schematics/Final Schematics/Power/Power_Schematic.brd (2014-04-17)

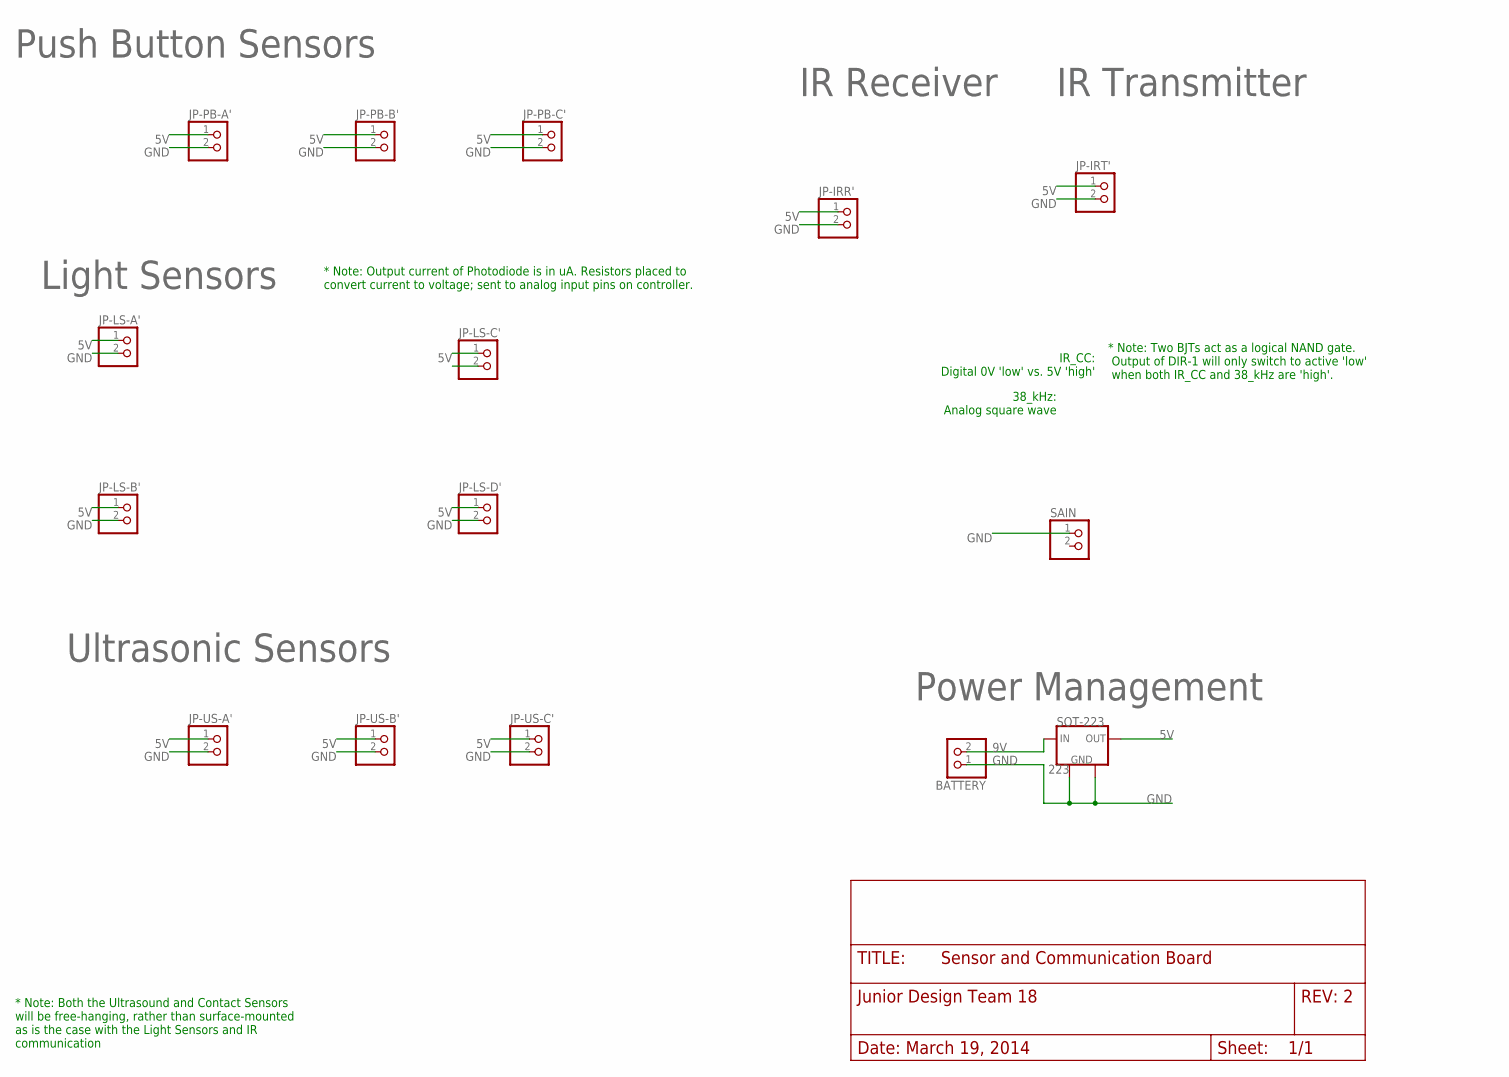
[picture p48: schematic Power_Schematic.sch]

Parts:
BATTERY: PINHD-1X2; 1X02
JP-IRR': PINHD-1X2; 1X02
JP-IRT': PINHD-1X2; 1X02
JP-LS-A': PINHD-1X2; 1X02
JP-LS-B': PINHD-1X2; 1X02
JP-LS-C': PINHD-1X2; 1X02
JP-LS-D': PINHD-1X2; 1X02
JP-PB-A': PINHD-1X2; 1X02
JP-PB-B': PINHD-1X2; 1X02
JP-PB-C': PINHD-1X2; 1X02
JP-US-A': PINHD-1X2; 1X02
JP-US-B': PINHD-1X2; 1X02
JP-US-C': PINHD-1X2; 1X02
SAIN: PINHD-1X2; 1X02
SOT-223: 223; SOT223

Connections:
5V: JP-IRR'.1, JP-IRT'.1, JP-LS-A'.1, JP-LS-B'.1, JP-LS-C'.1, JP-LS-D'.1, JP-PB-A'.1, JP-PB-B'.1, JP-PB-C'.1, JP-US-A'.1, JP-US-B'.1, JP-US-C'.1, SOT-223.GND1 (OUT)
9V-BAT: BATTERY.2, SOT-223.OUT (IN)
GND: BATTERY.1, JP-IRR'.2, JP-IRT'.2, JP-LS-A'.2, JP-LS-B'.2, JP-LS-C'.2, JP-LS-D'.2, JP-PB-A'.2, JP-PB-B'.2, JP-PB-C'.2, JP-US-A'.2, JP-US-B'.2, JP-US-C'.2, SAIN.1, SOT-223.GND2 (GND1), SOT-223.IN (GND2)

Notes on the sheet:
IR Receiver
IR Transmitter
Light Sensors
Ultrasonic Sensors
Push Button Sensors
* Note: Both the Ultrasound and Contact Sensors will be free-hanging, rather than surface-mounted as is the case with the Light Sensors and IR communication
Power Management
GND
* Note: Two BJTs act as a logical NAND gate. Output of DIR-1 will only switch to active 'low' when both IR_CC and 38_kHz are 'high'.
* Note: Output current of Photodiode is in uA. Resistors placed to convert current to voltage; sent to analog input pins on controller.
38_kHz: Analog square wave
IR_CC: Digital 0V 'low' vs. 5V 'high'

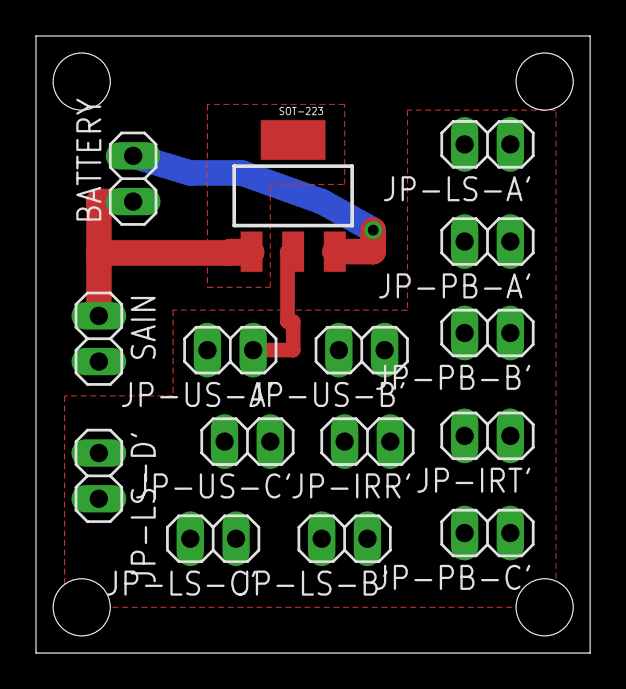
[picture p49: board Power_Schematic.brd from above]

Board: 2 copper layers, 30.8 x 34.3 mm, 15 parts (0 on the bottom side), 3 nets.
