zfeuers1/Junior-Design/RobotControl/RobotControl.ino

// ---------------------------------------------------------------------------
// RobotControl v1.4
//
// Created by Zachary Feuerstein - zfeuers1@binghamton.edu
//
// The MIT License (MIT)
//
// Copyright (c) 2014 Zachary Feuerstein
//
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
// THE SOFTWARE IS PROVIDED "AS IS", WITHOUT WARRANTY OF ANY KIND, EXPRESS OR
// IMPLIED, INCLUDING BUT NOT LIMITED TO THE WARRANTIES OF MERCHANTABILITY,
// FITNESS FOR A PARTICULAR PURPOSE AND NONINFRINGEMENT. IN NO EVENT SHALL THE
// AUTHORS OR COPYRIGHT HOLDERS BE LIABLE FOR ANY CLAIM, DAMAGES OR OTHER
// LIABILITY, WHETHER IN AN ACTION OF CONTRACT, TORT OR OTHERWISE, ARISING FROM,
// OUT OF OR IN CONNECTION WITH THE SOFTWARE OR THE USE OR OTHER DEALINGS IN
// THE SOFTWARE.
// ---------------------------------------------------------------------------
#include <movement.h>
#include <UltraSonicSystem.h>
#include <NewPing.h>
#include <PushButtonSystem.h>
#include <LightSensorSystem.h>
#include <IRCommSystem.h>

//----------------------------------------------------------------------------
// Movement Setup
//
#define RME 8 //Right Motor Enable
#define RMD 23 //Right Motor Direction
#define RMQA 25 //Right Motor input A from quadrature-encoder
#define RMQB 27 //Right Motor input B from quadrature-encoder
//
#define LME 9 //Same stuff just with left motor
#define LMD 22
#define LMQA 24
#define LMQB 26
//
#define Speed 180
//
movement Robot(RMD, RME, RMQA, RMQB, LMD, LME, LMQA, LMQB, Speed);
//
//----------------------------------------------------------------------------
// UltraSonic Setup
//
#define RTP 2 //Right Trigger Pin
#define REP 3 //Right Echo Pin
// 
//Same for Left and Front sensors
#define LTP 4
#define LEP 5
#define FTP 6
#define FEP 7
//
#define maxDistance 200
//
UltraSonicSystem USSensors(LTP, LEP, RTP, REP, FTP, FEP, maxDistance);
//
//----------------------------------------------------------------------------
// Light Sensor Setup  
//
#define FL A0//front left sensor
#define FR A1
#define BL A2//back left sensor
#define BR A3
//
LightSensorSystem LSensors(FL, FR, BL, BR);
//
//----------------------------------------------------------------------------
// Push Button Setup
//
#define LPB 50
#define MPB 51
#define RPB 52
//
PushButtonSystem PushButtons(LPB, MPB, RPB);
//
//----------------------------------------------------------------------------
// IR Communication Setup
//
#define modPin 13
//
IRCommSystem IR(modPin);
//
//----------------------------------------------------------------------------
// Main Robot Control
//


void setup(){
  Serial.begin(9600);//set up for printing to console
}



void loop(){
  
  //-----------------------------------------------------
  // Wait until right button is pressed to begin
  //
  
  bool off = true;
  
  while(off){
    PushButtons.readIfPressed();
    off = PushButtons.Right;
  }
  
  bool start = false;
  while(!start){
    PushButtons.readIfPressed();
    start = PushButtons.Right;
    Serial.println(start);
  } 
  Serial.println("broke out;");
  //
  //-----------------------------------------------------
  //-----------------------------------------------------
  // Wait until pen is lifted to begin game
  //
  
  bool inPen = true;
  float lastDistanceFront;
  USSensors.getDistances();
  lastDistanceFront = USSensors.distanceFront;
  
  while(inPen){
    USSensors.getDistances();
    if((USSensors.distanceFront - lastDistanceFront) > 5){
      inPen = false;
    }
  }
  
  
  //
  //-----------------------------------------------------
  //-----------------------------------------------------
  // Play game for 3 min.
  unsigned long startTime = millis();
  unsigned long time = 0;
  bool interrupt = true;
  int gameTime = 0;
  
  Robot.setDirectionForward();
  
  Serial.println("\nabout to start game");  
  
  while(gameTime < 180000){//180000 ms = 3 min
    //-----------------------------------------------------
    // Game loop
      Serial.println("\nPlaying game");

      bool atTower = false;
      atTower = LSensors.atBeacon();
      
      bool atObstacle = false;
      USSensors.getDistances();
      PushButtons.readIfPressed();
      
      if((USSensors.distanceFront > 0) && (USSensors.distanceFront < 5.5)){
        atObstacle = true;
      }else if(PushButtons.Right || PushButtons.Middle || PushButtons.Left)
      {
        atObstacle = true;
      }
      
      interrupt = atObstacle | atTower;
      
      if(interrupt){
        //---------------------------------------------------
        // Check if at beacon and if so try to capture it
        //
        if(atTower){
          delay(3000);
          CaptureBeacon();
         }
        //
        //---------------------------------------------------
        // Check if at obstacle and avoid it
        // 
        else if(atObstacle){
           obstacleAvoidance();
        }
        //
        //-----------------------------------------------------
      }else{

        Robot.setDirectionForward();
        Serial.println("\nAbout to go");
        Robot.goXinches(1);
      }
    
    //---------------------------------------------------
    // Calculate what direction the beacon is and turn to it
    //
    //    
       int degree;
       degree = LSensors.calcDirection();
       Serial.println("Turn this degree: ");
       Serial.println(degree);
       Robot.turnXdegrees(degree);
    //   
    //    
    //---------------------------------------------------  
    
    
    time = millis();
    gameTime = (time - startTime);
  }
  
  
  //
  //-----------------------------------------------------
}
//
//----------------------------------------------------------------------------
//
// Function to avoid obstacles

void obstacleAvoidance(){

  float distanceOnRight;
  float distanceOnLeft;
          
  delay(500);
  Robot.setDirectionBackward();
  Robot.goXinches(1.8);
  delay(500);
          
  USSensors.getDistances();
          
  if(USSensors.distanceRight != 0){
    distanceOnRight = USSensors.distanceRight;
  }else{
    distanceOnRight = 400;
  }
  if(USSensors.distanceLeft != 0){
    distanceOnLeft = USSensors.distanceLeft;
  }else{
    distanceOnLeft = 400;
  }
          
  if(distanceOnRight >= distanceOnLeft){
    Robot.turnXdegrees(90);          
  }else{
    Robot.turnXdegrees(90);
  }      
  delay(500);
  Robot.setDirectionForward();
  Robot.goXinches(1); 
}
//
//----------------------------------------------------------------------------
//
// Function to capture a beacon

void CaptureBeacon(){
  
  if((LSensors.FrontLeftSensor + LSensors.FrontRightSensor) < 1400){
    if(LSensors.FrontRightSensor >= 750){
      Robot.turnXdegrees(45);
    }else if(LSensors.FrontLeftSensor >= 750){
      Robot.turnXdegrees(-45);
    }else if(LSensors.BackLeftSensor >= 750){
      Robot.turnXdegrees(-135);
    }else if(LSensors.BackRightSensor >= 750){
      Robot.turnXdegrees(135);
    }else{
      //assume in front
    }
  }

  
  int angle = 20;
  for(int i=0; i<4;i++){
    IR.SetupSerial();
    comm();
    delay(1000 + i);
    Robot.turnXdegrees(angle);
    angle = angle * -1;
    angle = angle - 5;
  }
  IR.EndSerial();
          
  Robot.setDirectionBackward();
  Robot.goXinches(1.5);
  Robot.turnXdegrees(180);
  Robot.setDirectionForward();
}  
//
//----------------------------------------------------------------------------


void comm(){

  byte data = 0;
  unsigned long StartTime = millis();
  
  //Read data
  while (Serial2.available() > 0)
  {
    data = Serial2.read();
    
    //Start Carrier
    tone(13, 38000);
  
    //If serial data is available, sent the bitwise inversion of it back out 
    Serial2.write(~data);

    //Wait for send to complete
    while ((millis() - StartTime) <50){}
    unsigned long StartTime = millis();

    //Stop Carrier
    noTone(13);
  
    //Set as output
    pinMode(13, OUTPUT);
  
  	//Set low
    digitalWrite(13, LOW);
    if (Serial2.available() > 0) 
    Serial2.read();
  
  }


  //Clear the read buffer
  if (Serial2.available() > 0) 
    Serial2.read();

}
