zfeuers1/Junior-Design/(commit log)

2014-02-28 power management
2014-03-05 button and ultrasonic tester code
2014-03-05 Libray used for ultrasonic sensor
2014-03-06 adding schematics
    [Arduino_MEGA_2560-Rev3.brd, Arduino_MEGA_2560-Rev3.sch, SensorCircuits1.sch, SensorCircuits2.sch]
2014-03-07 added BOM
2014-03-07 added Flowcharts
2014-03-12 added lightSe Sensor Readings
    [Controller Interface:Headers.sch, LightSensorReadings.xlsx, Member Contributions.xlsx]
2014-04-17 added new code and ogranized everything
    [Arduino_MEGA_2560-Rev3.brd, Arduino_MEGA_2560-Rev3.sch, Controller Interface:Headers.sch, Final Schematic.brd, Final Schematic.sch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]
2014-04-18 started the Light Sensor Algorithm
2014-05-05 fixed which button to start game
    [RobotControl.ino]
2014-05-07 added some obstacle avoidance
    [RobotControl.ino]
2014-05-08 added final obstacle avoidance algorithm (may need some tweaking. aka not 'final')
    [RobotControl.ino]
